PenguinEino/opensusi-tr10-sram512/klayout/dense_sram/array_and_fit.png

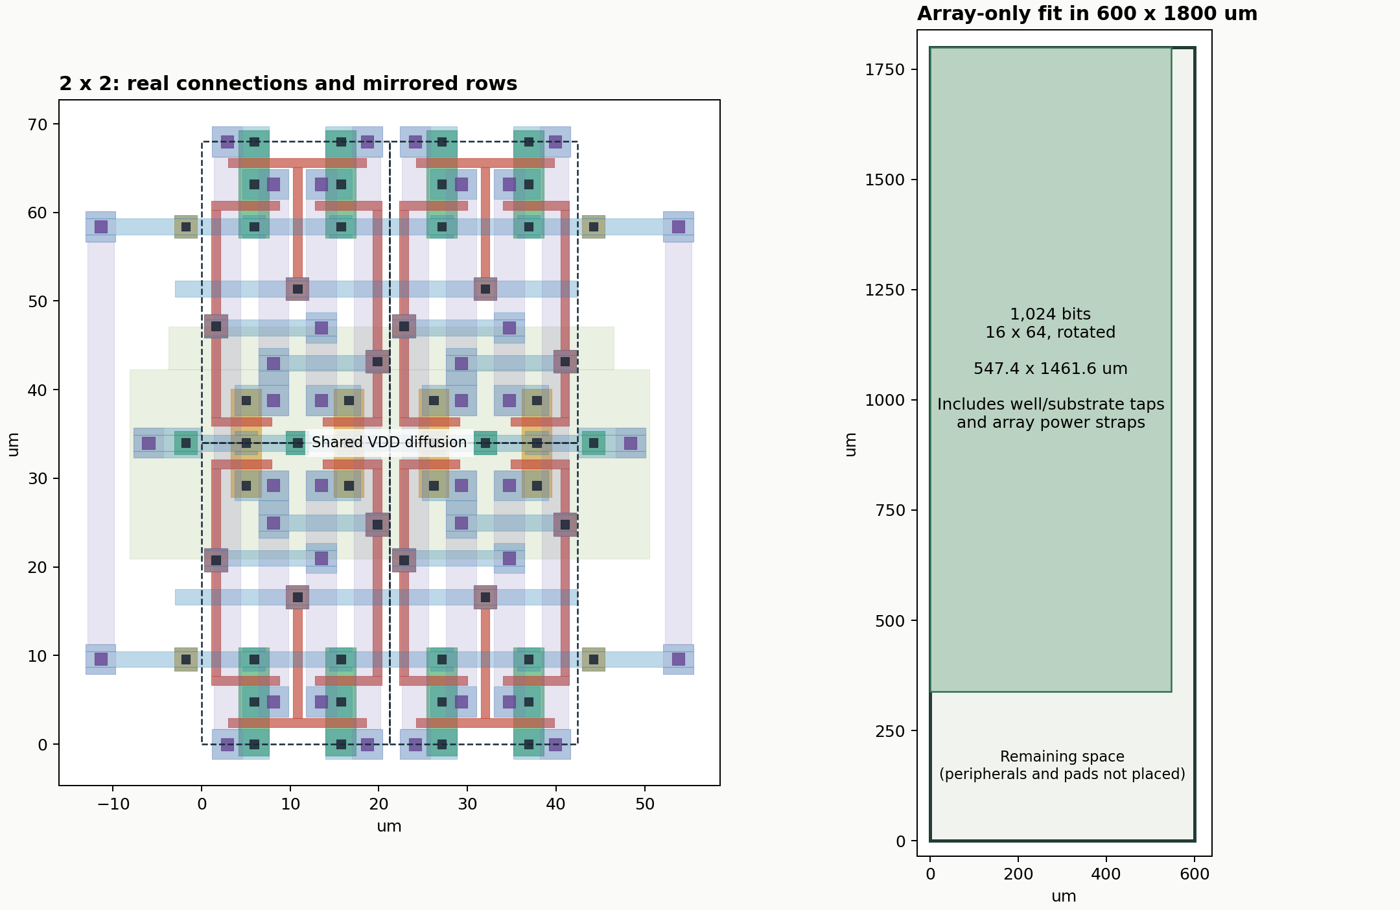
klayout/dense_sram/array_and_fit.png
