PenguinEino/opensusi-tr10-sram512/klayout/dense_sram/comparison.png

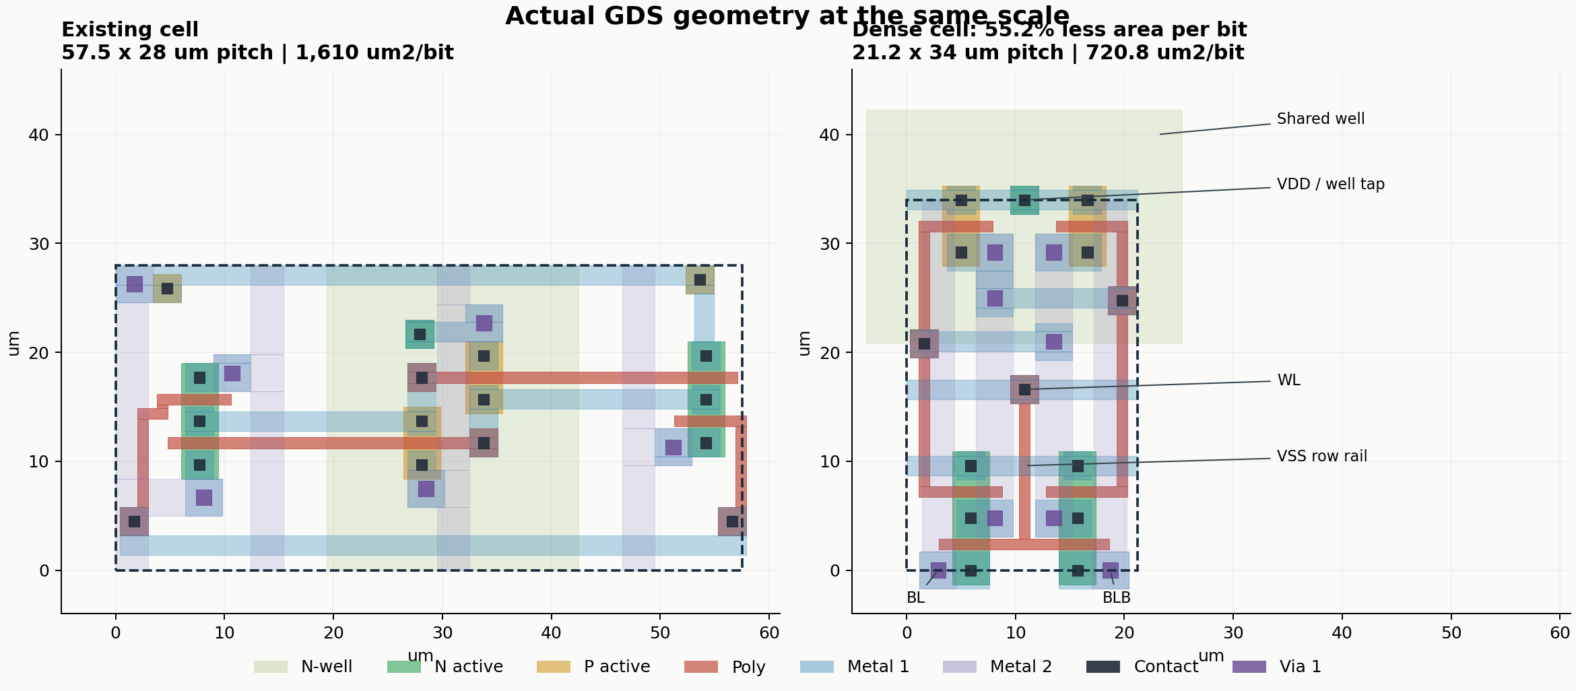
klayout/dense_sram/comparison.png
