PenguinEino/opensusi-tr10-sram512/klayout/sram_compact/capacity.png

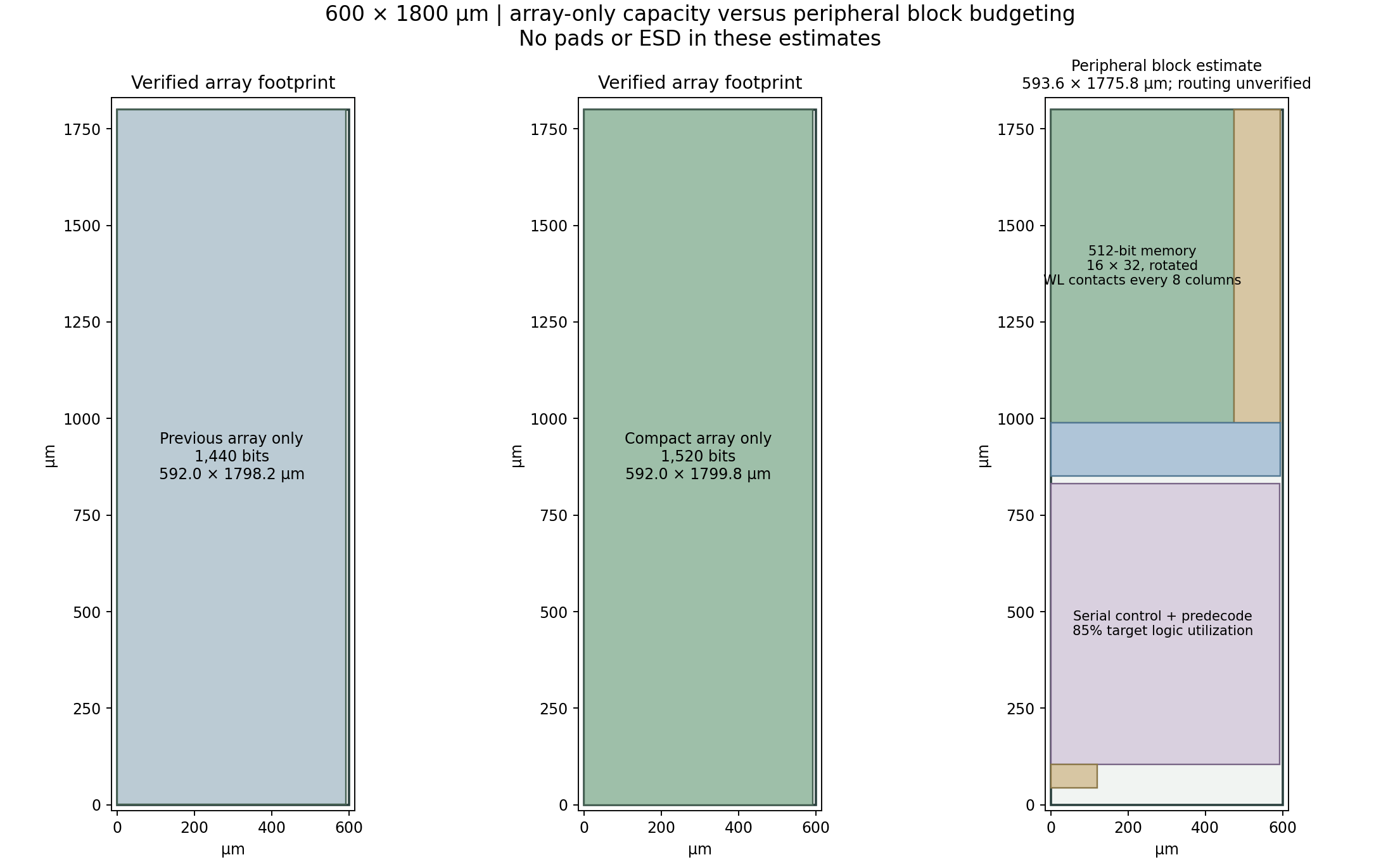
klayout/sram_compact/capacity.png
