PenguinEino/opensusi-tr10-sram512/klayout/sram_compact/cell_comparison.png

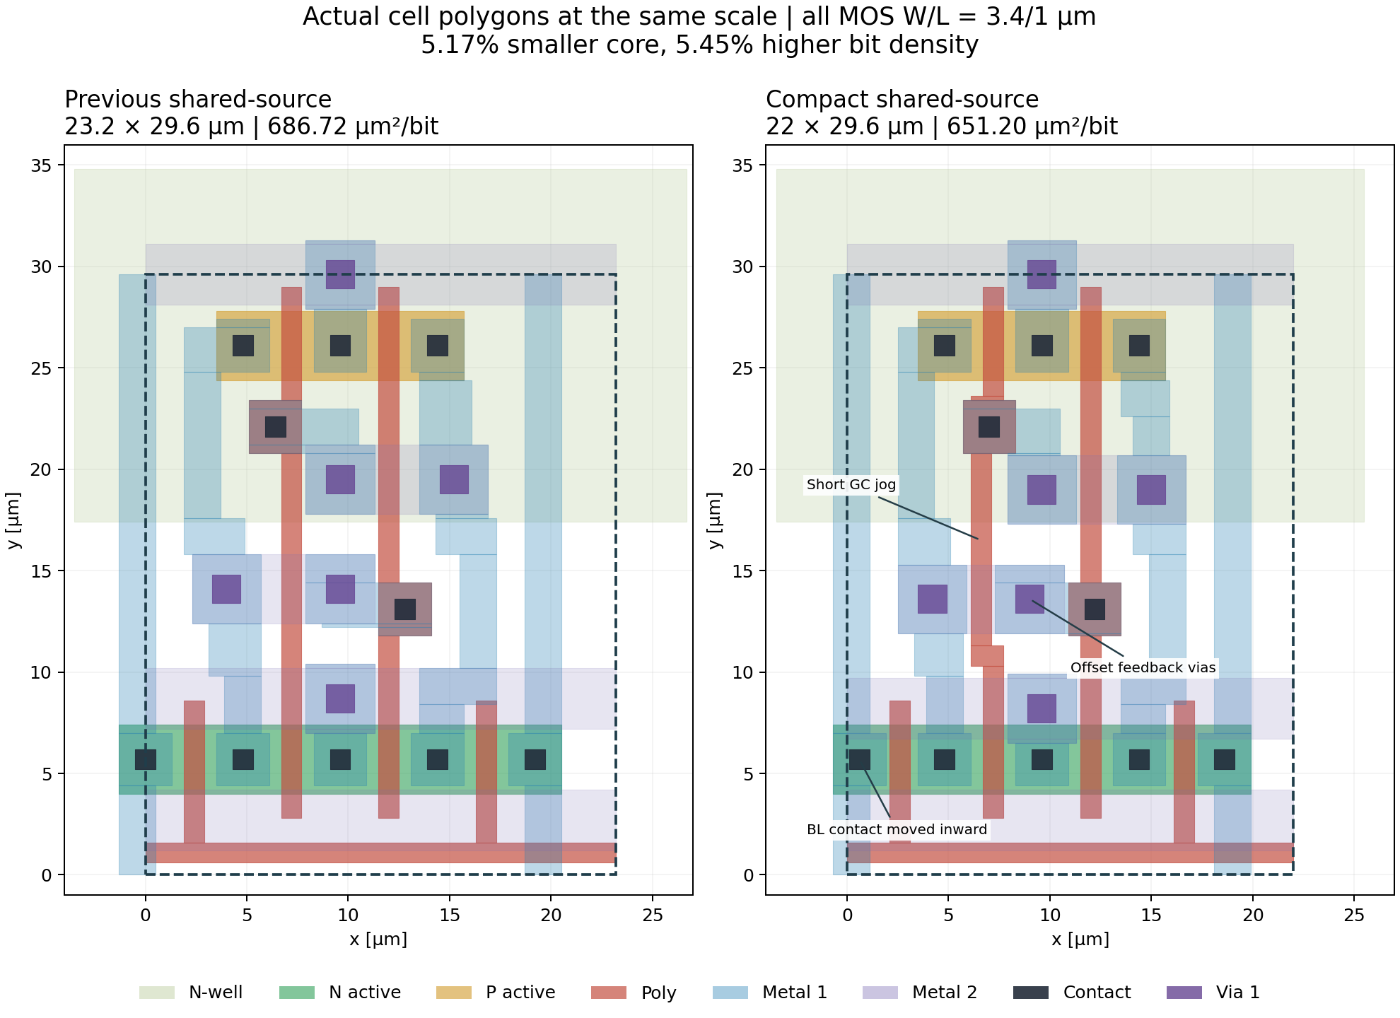
klayout/sram_compact/cell_comparison.png
