PenguinEino/opensusi-tr10-sram512/klayout/sram_macro_study/floorplans.png

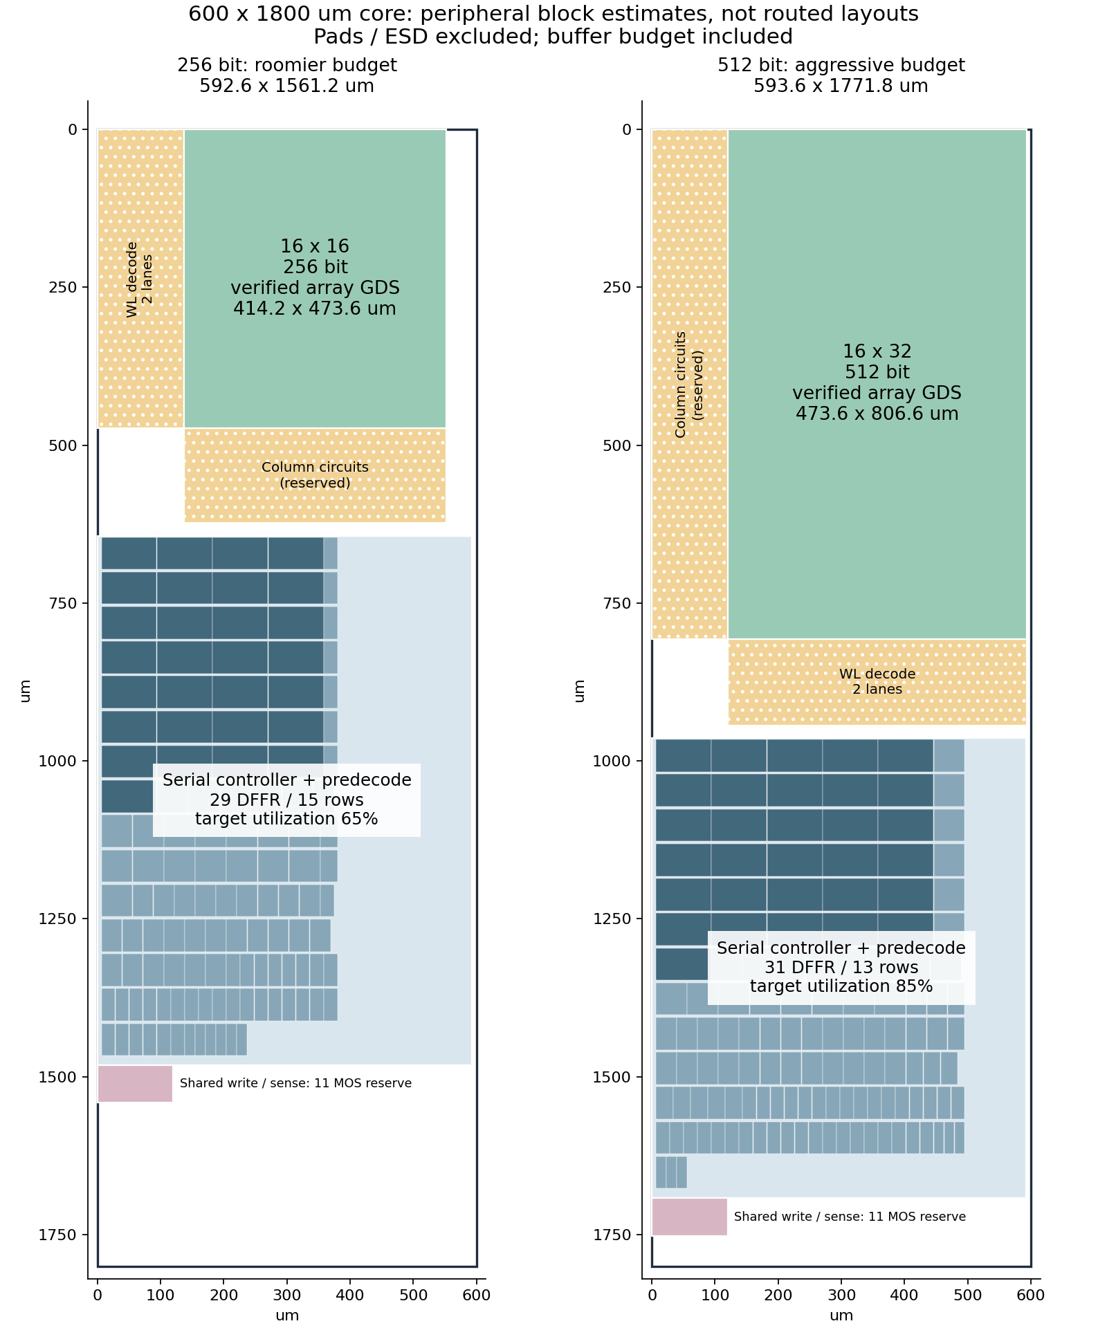
klayout/sram_macro_study/floorplans.png
