PenguinEino/opensusi-tr10-sram512/klayout/sram_macro_study/pitch.png

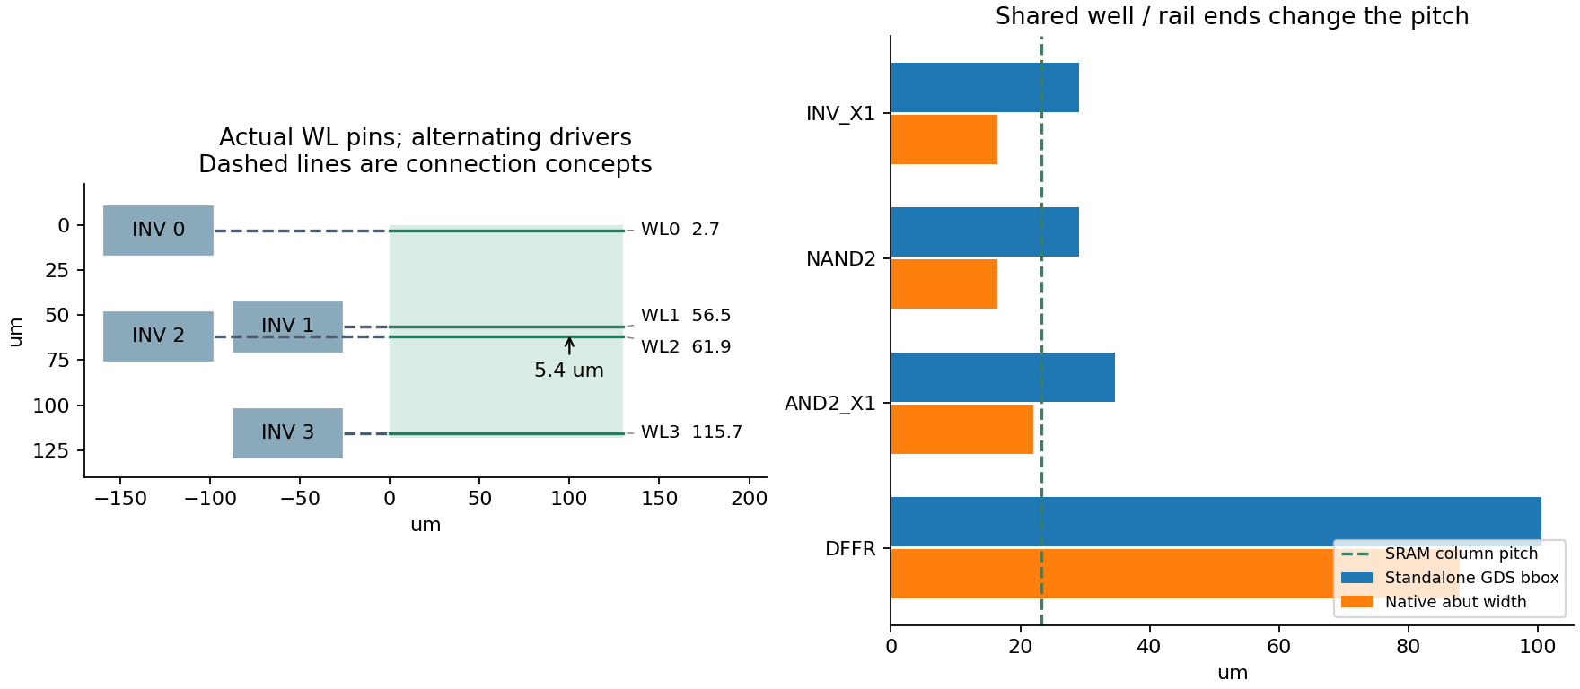
klayout/sram_macro_study/pitch.png
