PenguinEino/opensusi-tr10-sram512/klayout/sram_macro_study/strap_tradeoff.png

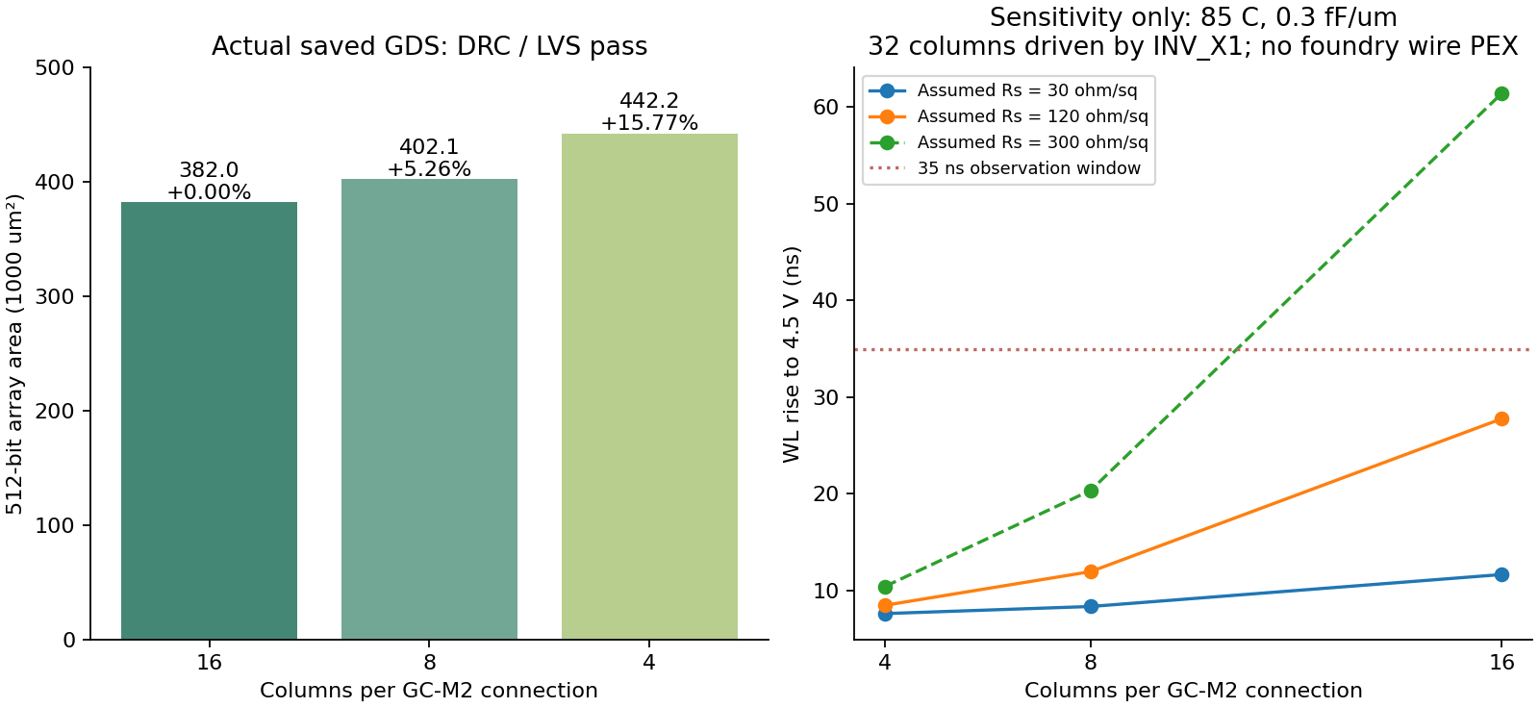
klayout/sram_macro_study/strap_tradeoff.png
