PenguinEino/opensusi-tr10-sram512/klayout/sram_pcell/scan_comparison.png

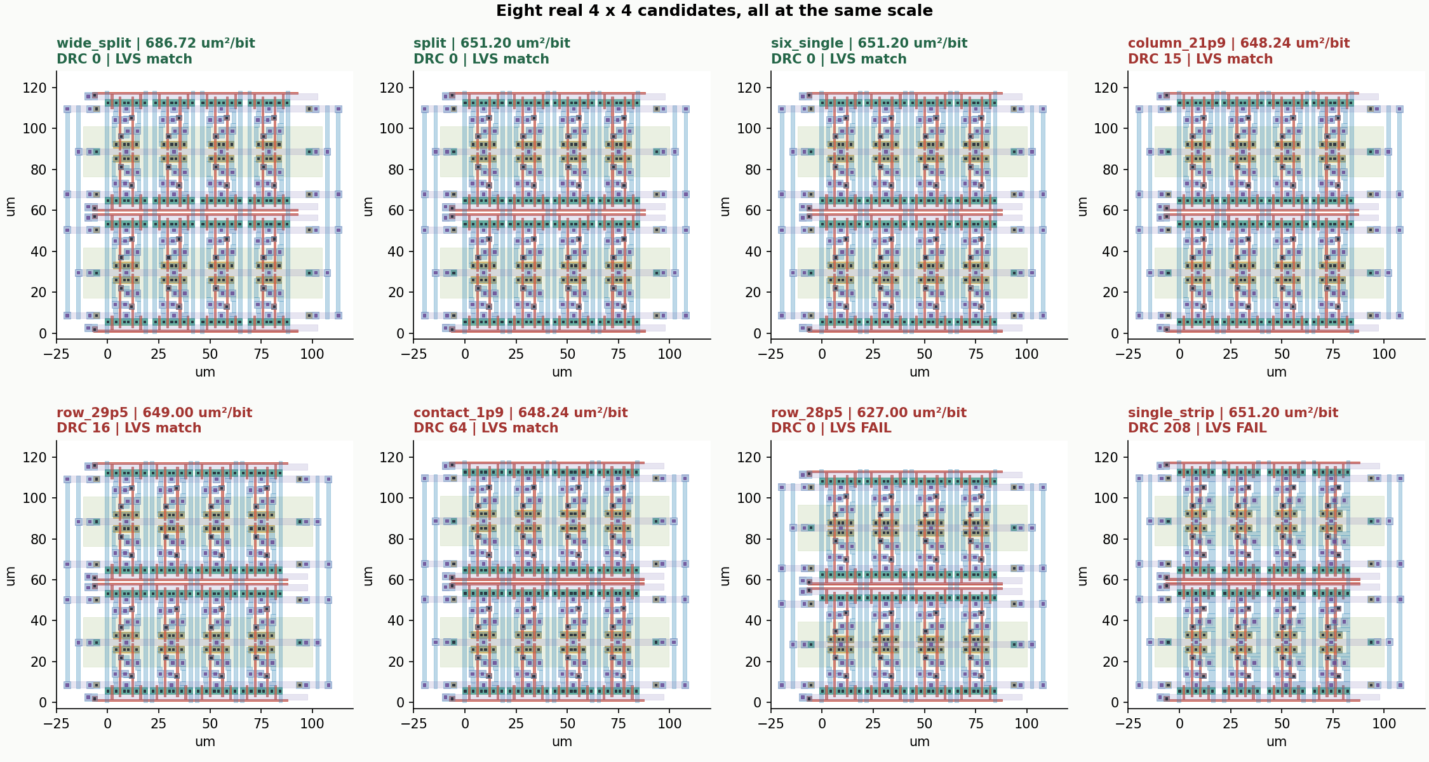
klayout/sram_pcell/scan_comparison.png
