PenguinEino/opensusi-tr10-sram512/klayout/sram_pcell/shared_capacity.png

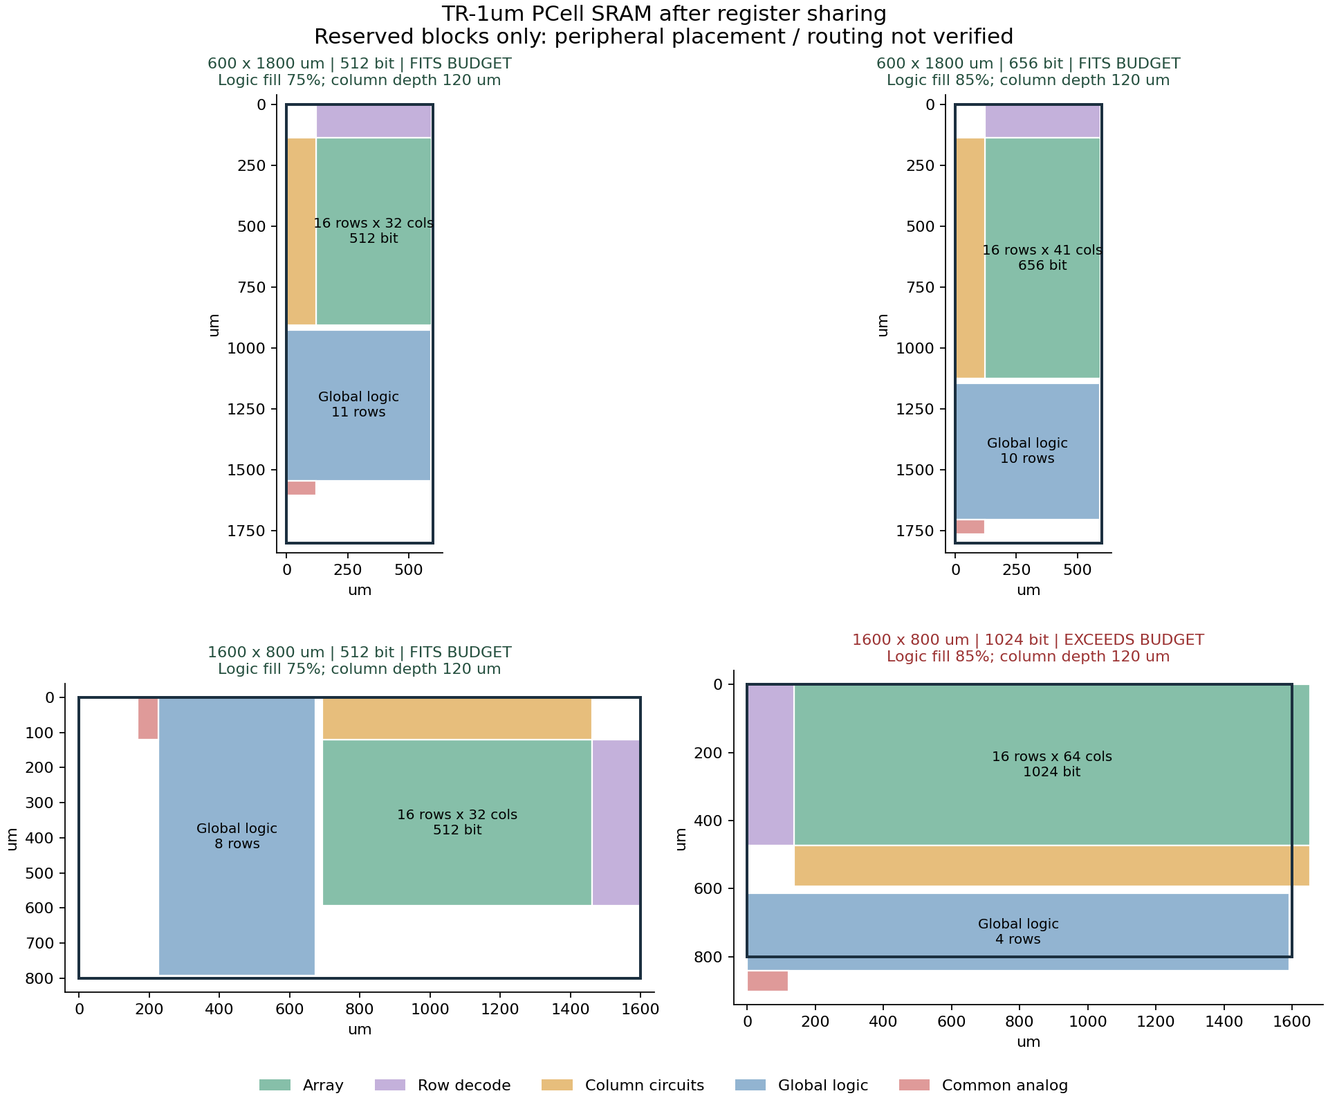
klayout/sram_pcell/shared_capacity.png
