PenguinEino/opensusi-tr10-sram512/klayout/sram_research/array_comparison.png

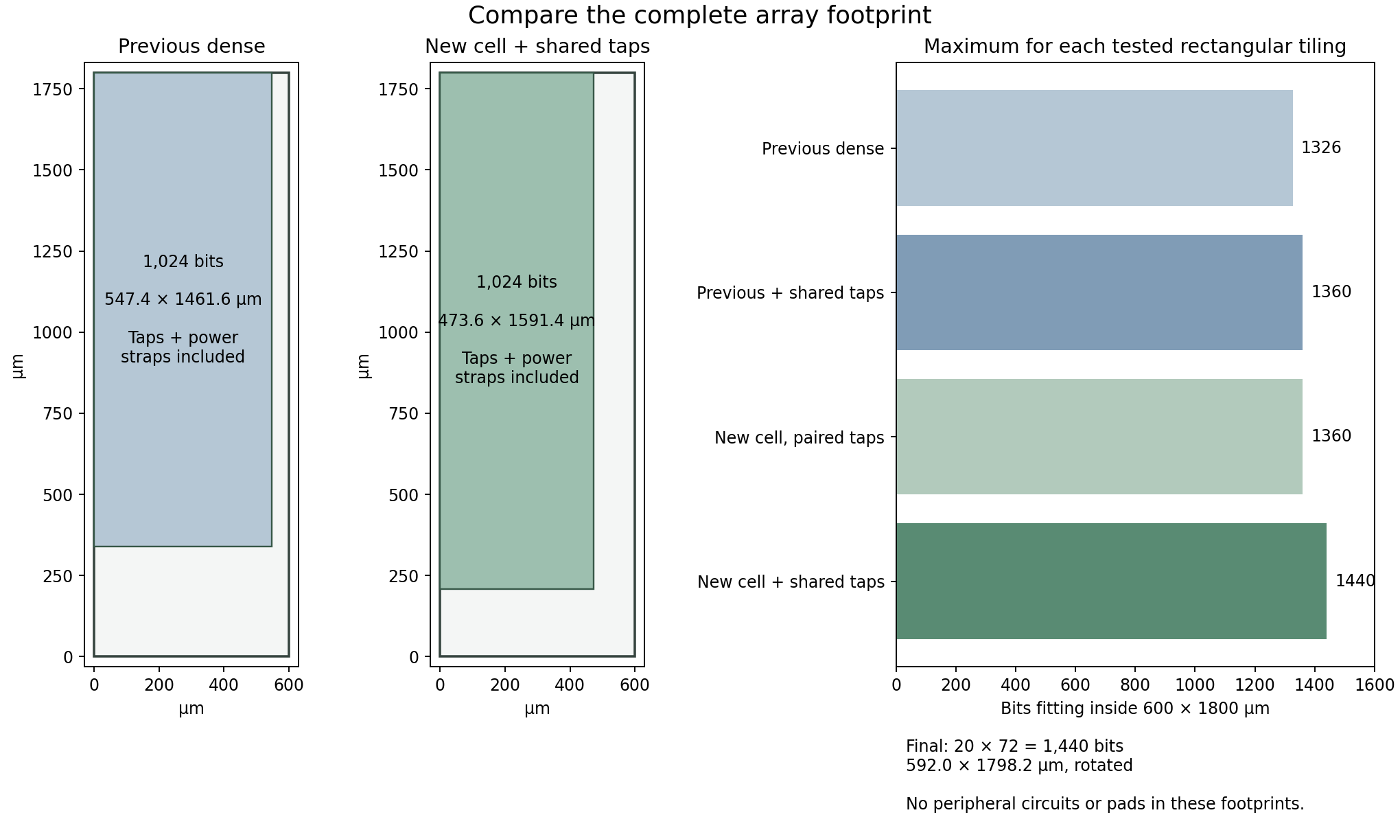
klayout/sram_research/array_comparison.png
