PenguinEino/opensusi-tr10-sram512/klayout/sram_research/array_detail.png

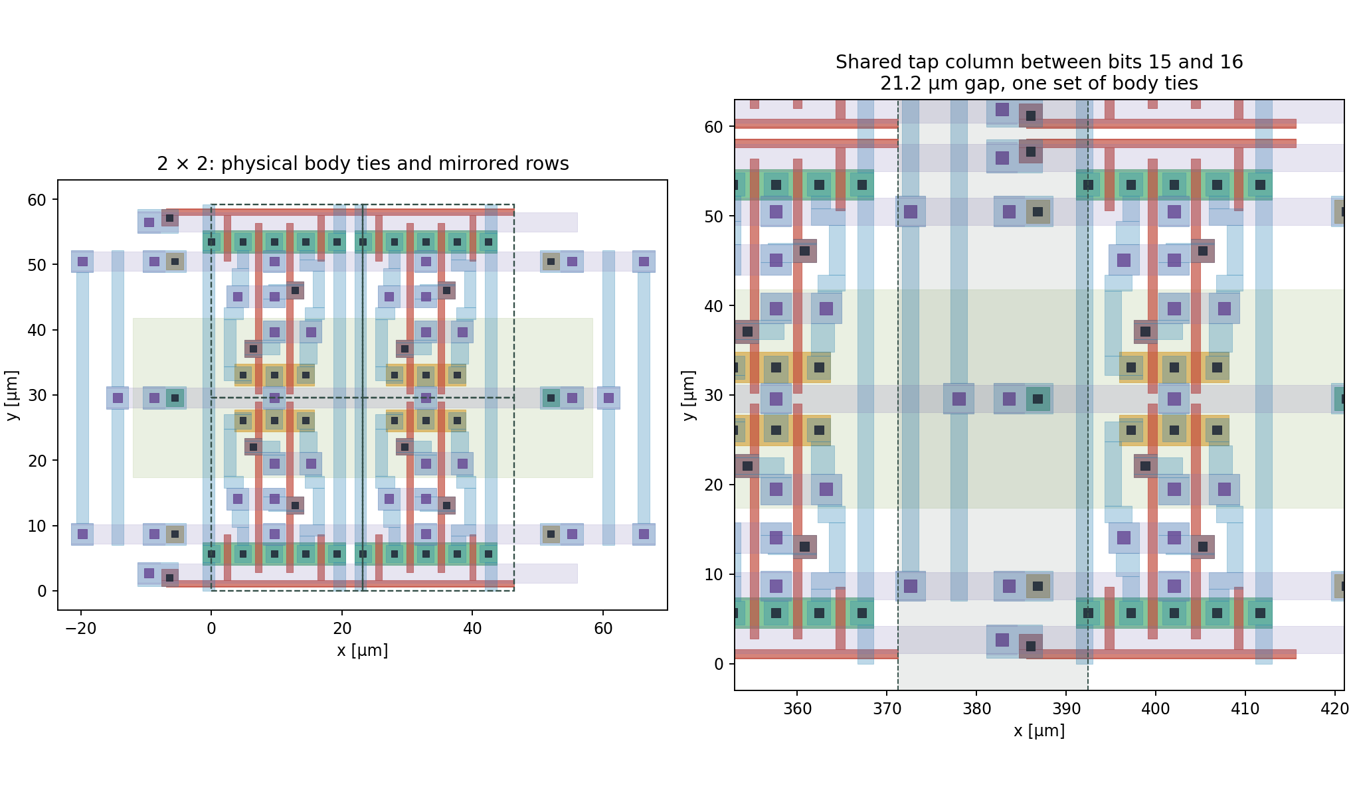
klayout/sram_research/array_detail.png
