PenguinEino/opensusi-tr10-sram512/klayout/sram_research/stability.png

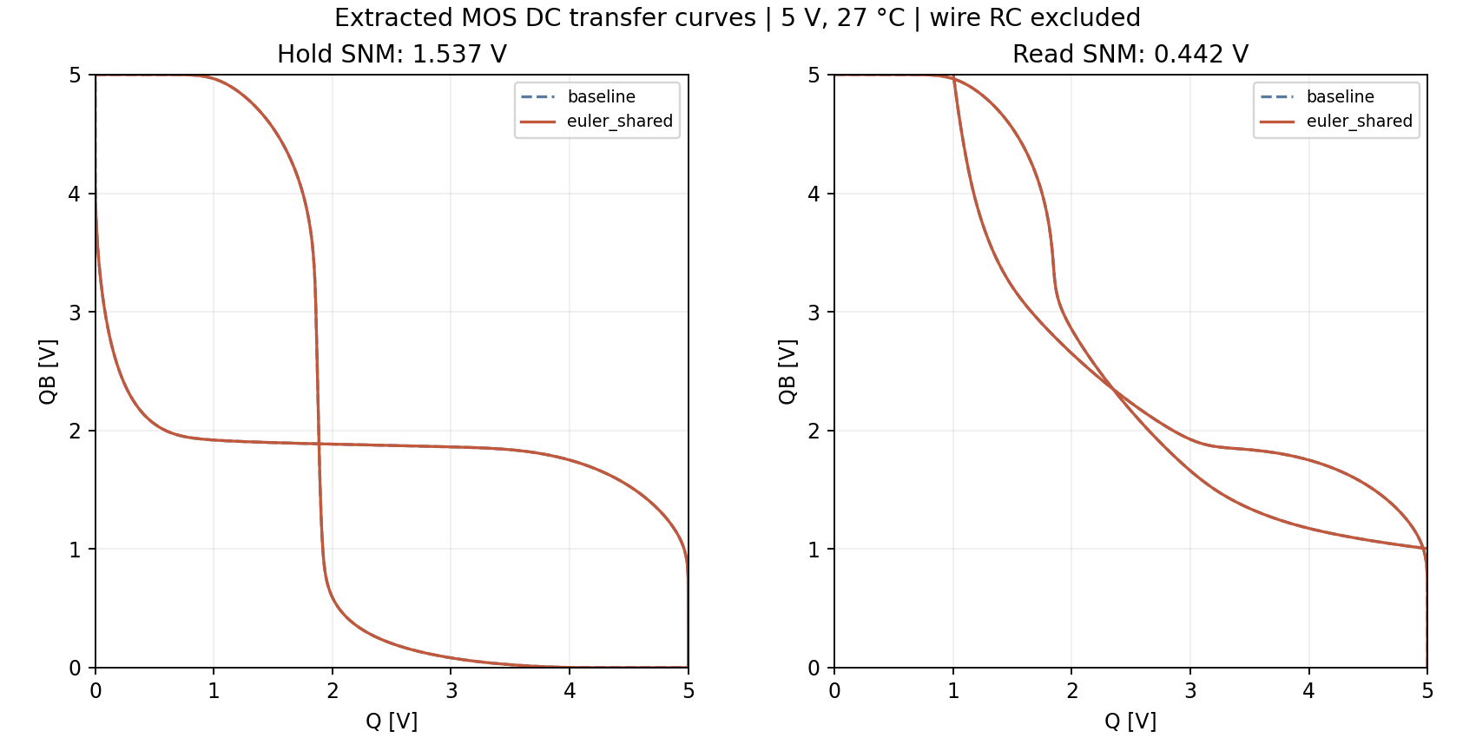
klayout/sram_research/stability.png
