PenguinEino/opensusi-tr10-sram512/klayout/sram_t4/array_comparison.png

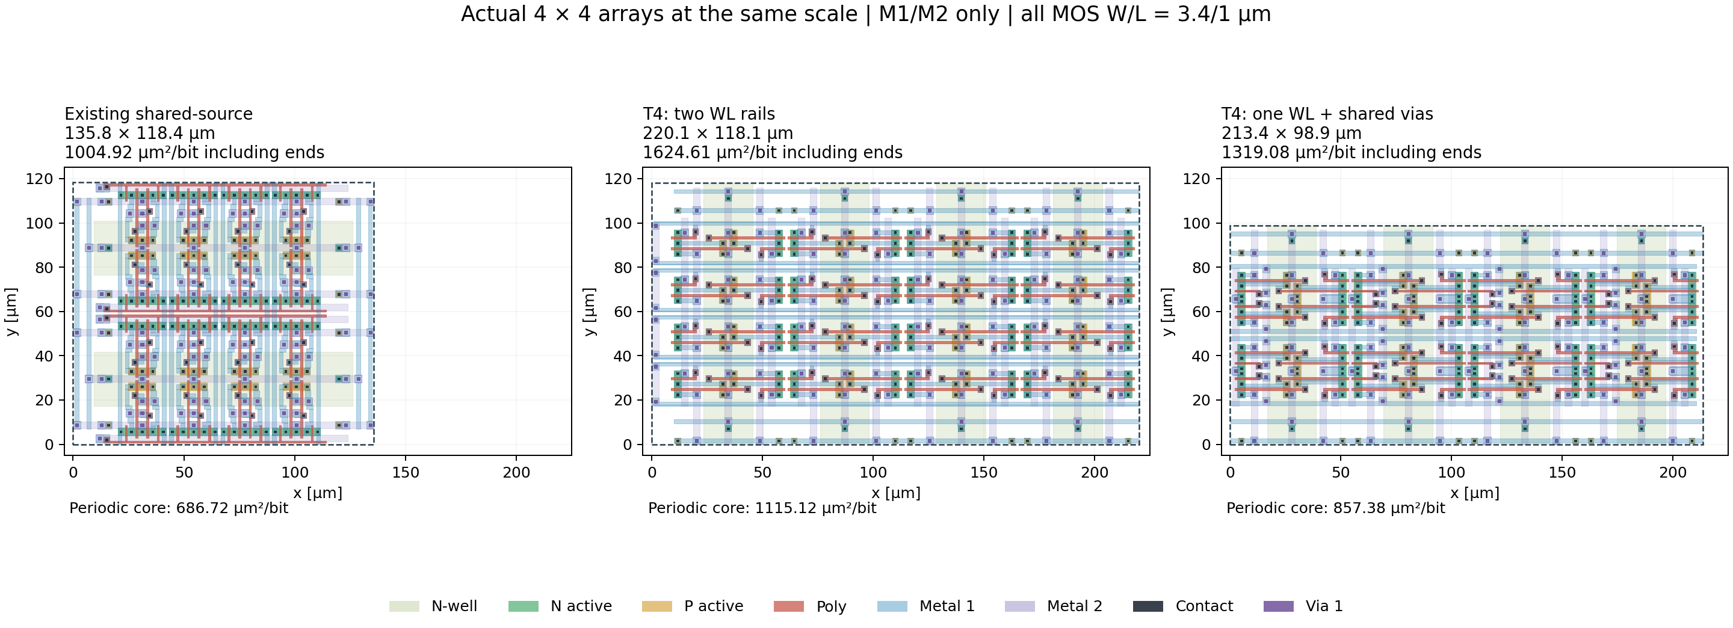
klayout/sram_t4/array_comparison.png
