PenguinEino/opensusi-tr10-sram512/klayout/sram_t4/singlewl_detail.png

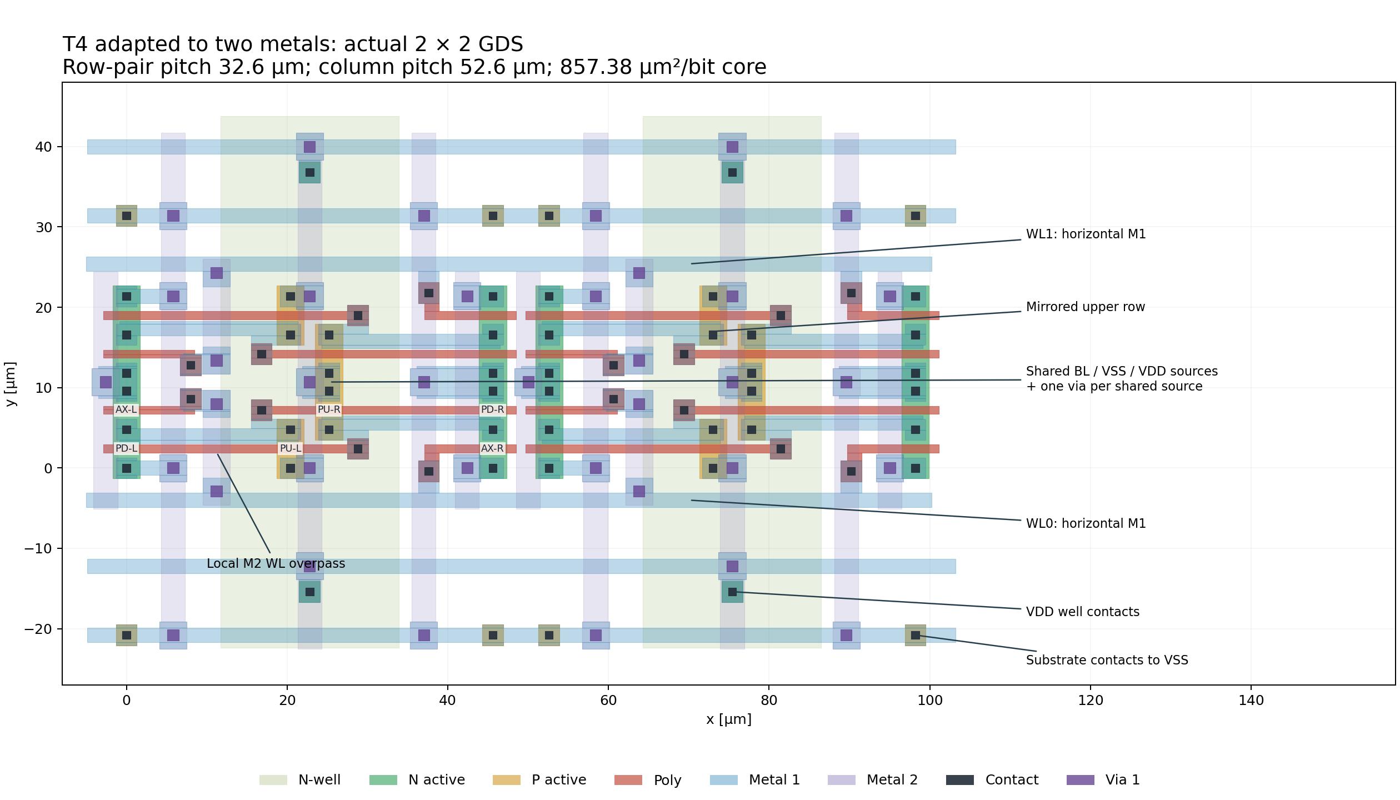
klayout/sram_t4/singlewl_detail.png
