PenguinEino/opensusi-tr10-sram512/learning/simulation/cell_sense_capacitance.png

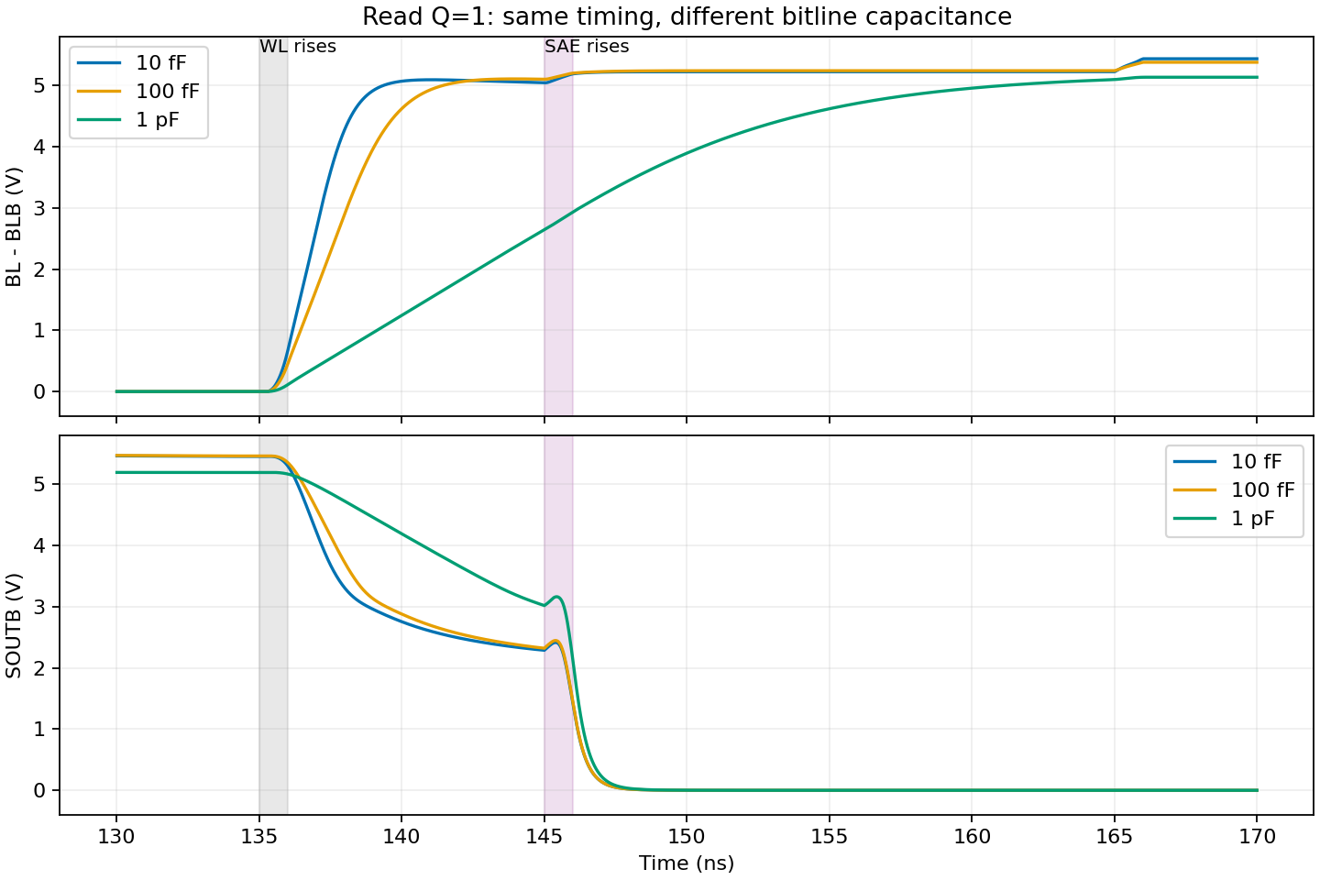
learning/simulation/cell_sense_capacitance.png
