PenguinEino/opensusi-tr10-sram512/reviews/sram512_review_2026-09-13.png

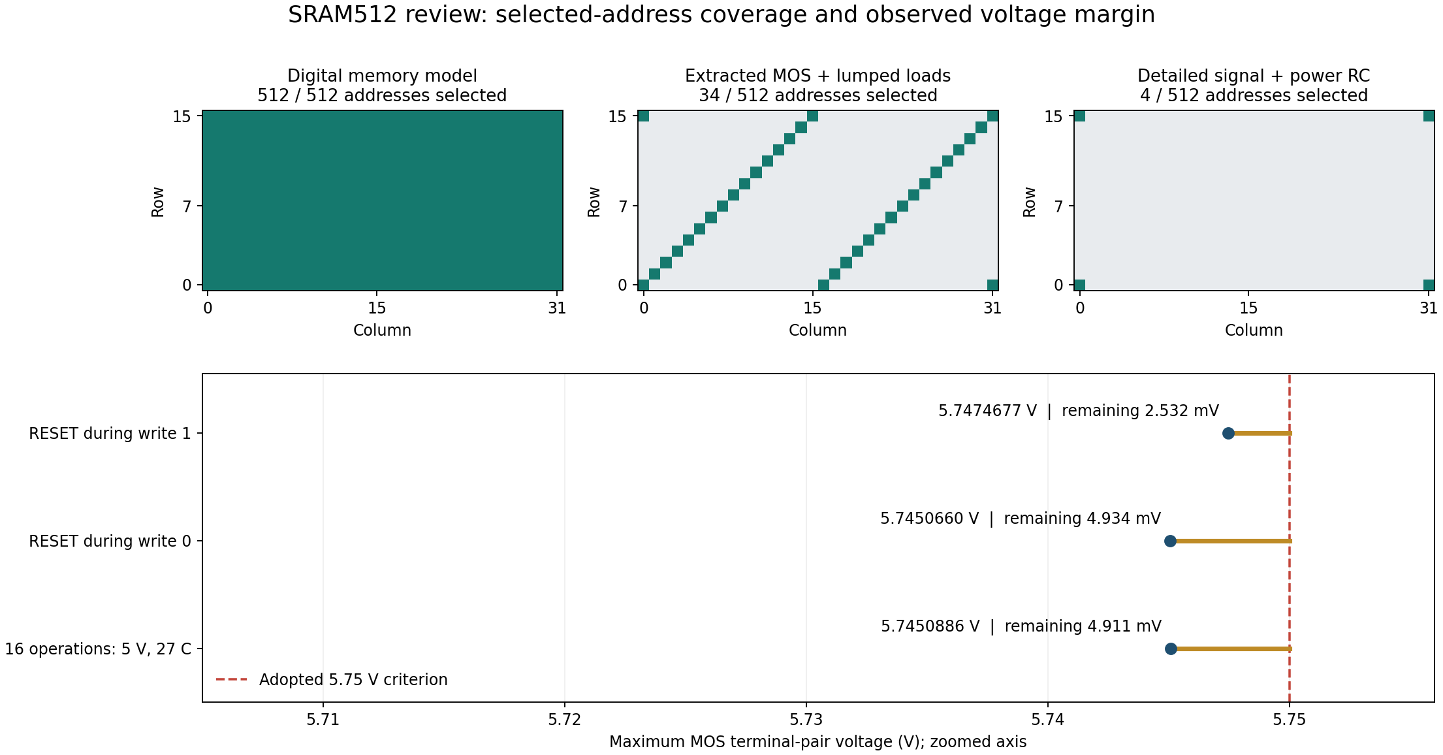
reviews/sram512_review_2026-09-13.png
