PenguinEino/opensusi-tr10-sram512/reviews/sram_review_2026-09-11.png

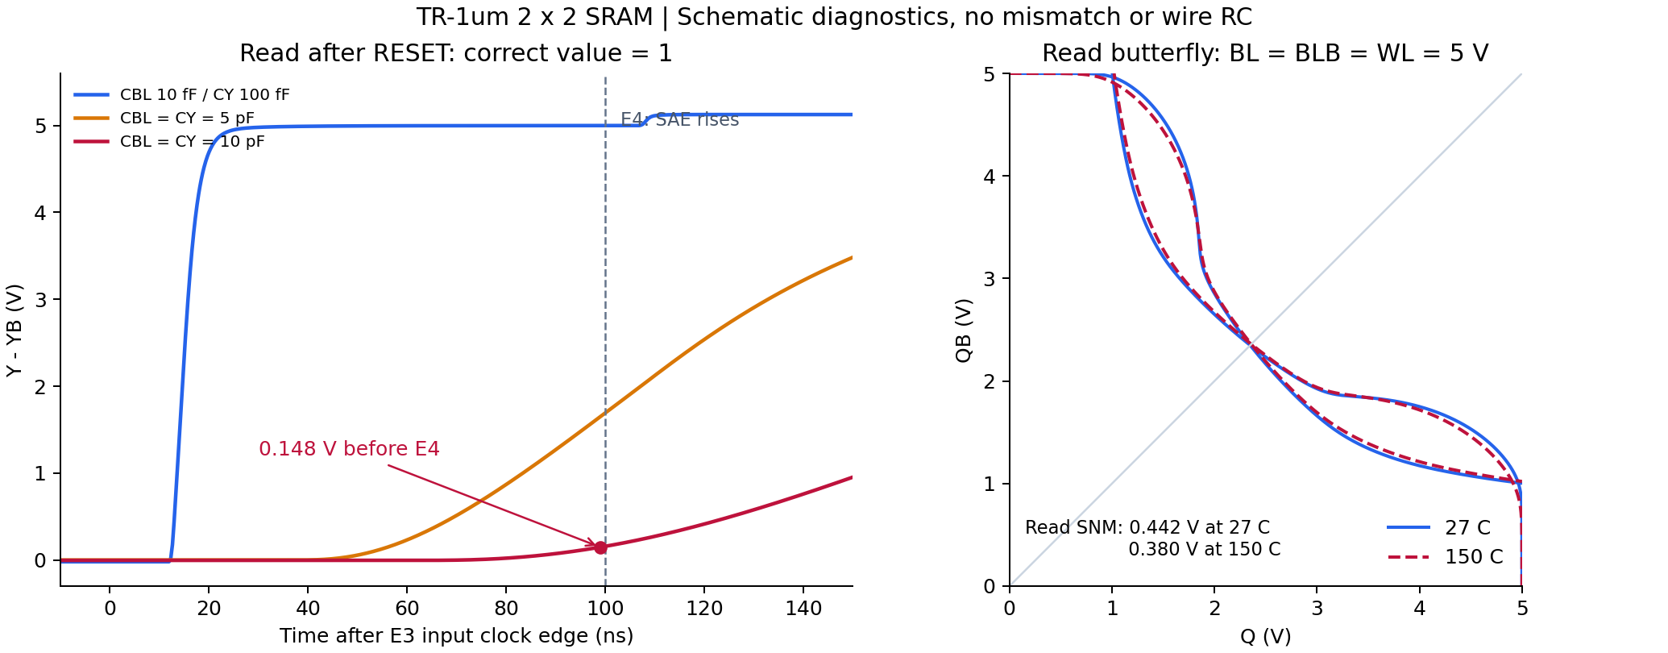
reviews/sram_review_2026-09-11.png
