PenguinEino/opensusi-tr10-sram512/reviews/sram_shared_frame_retest_2026-09-12.png

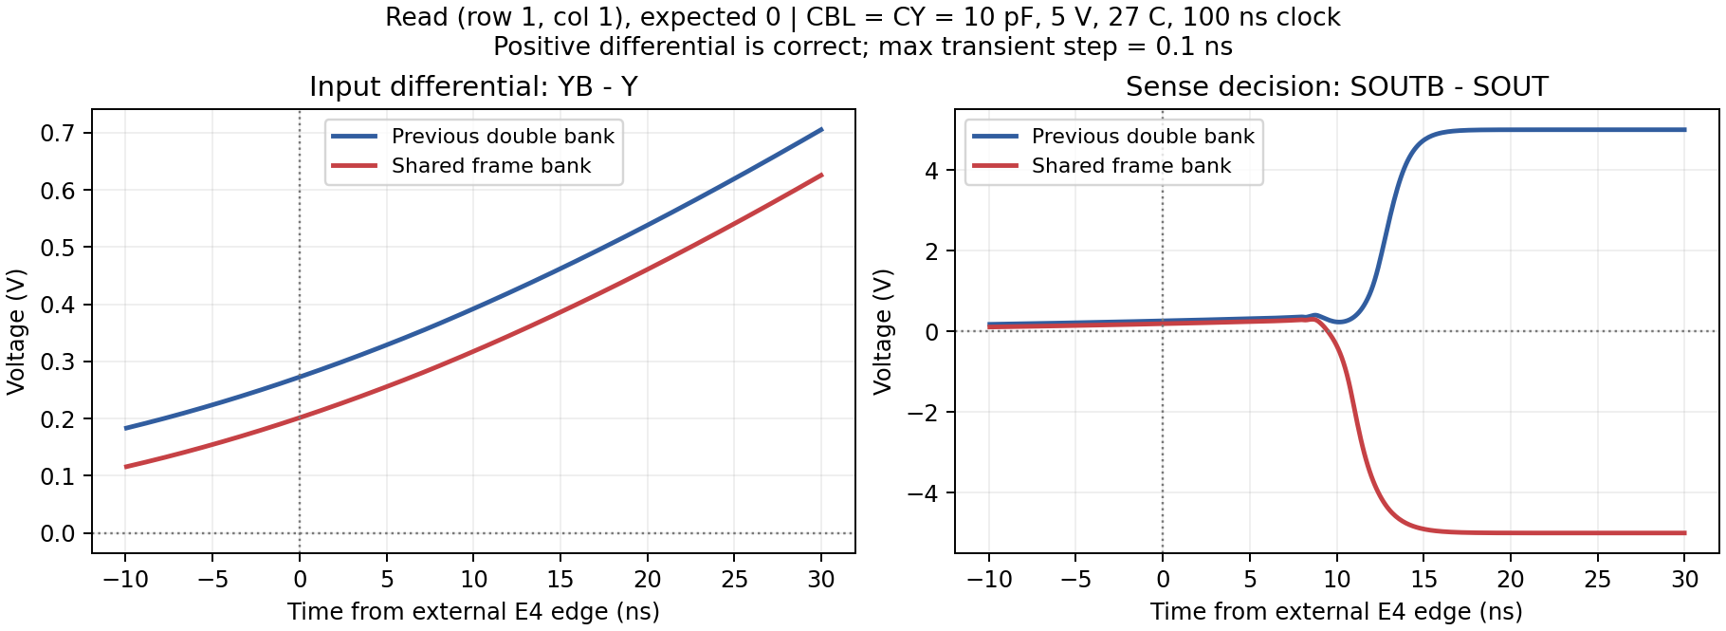
reviews/sram_shared_frame_retest_2026-09-12.png
