PenguinEino/opensusi-tr10-sram512/sram512/reports/decoderfix_route_waveforms.png

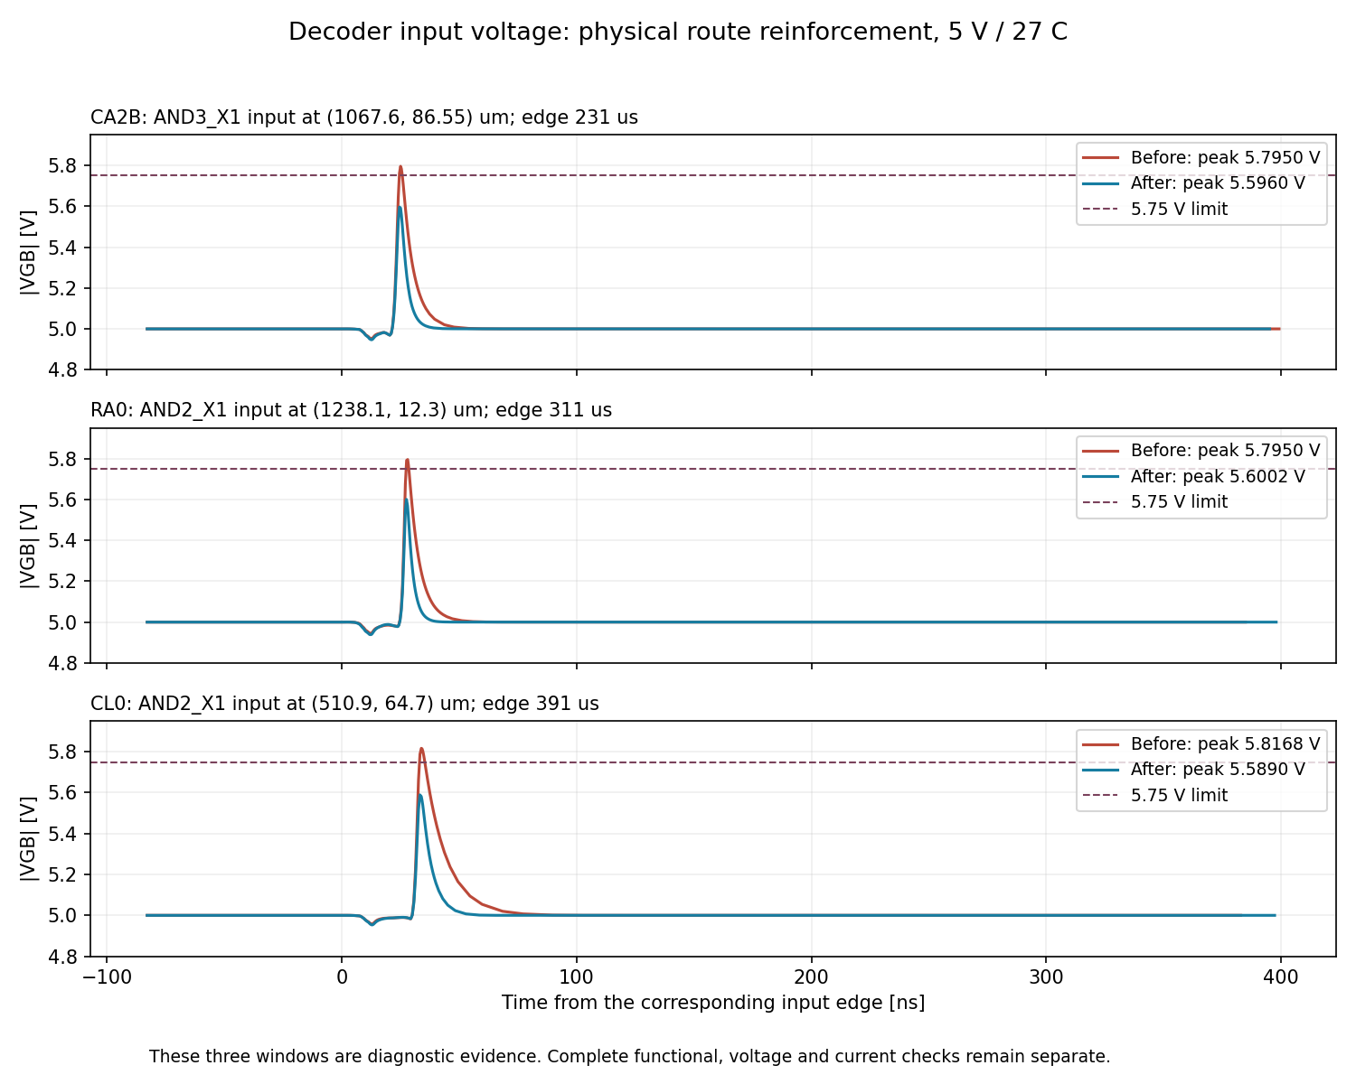
sram512/reports/decoderfix_route_waveforms.png
