PenguinEino/opensusi-tr10-sram512/sram512/reports/decoderfix_startup.png

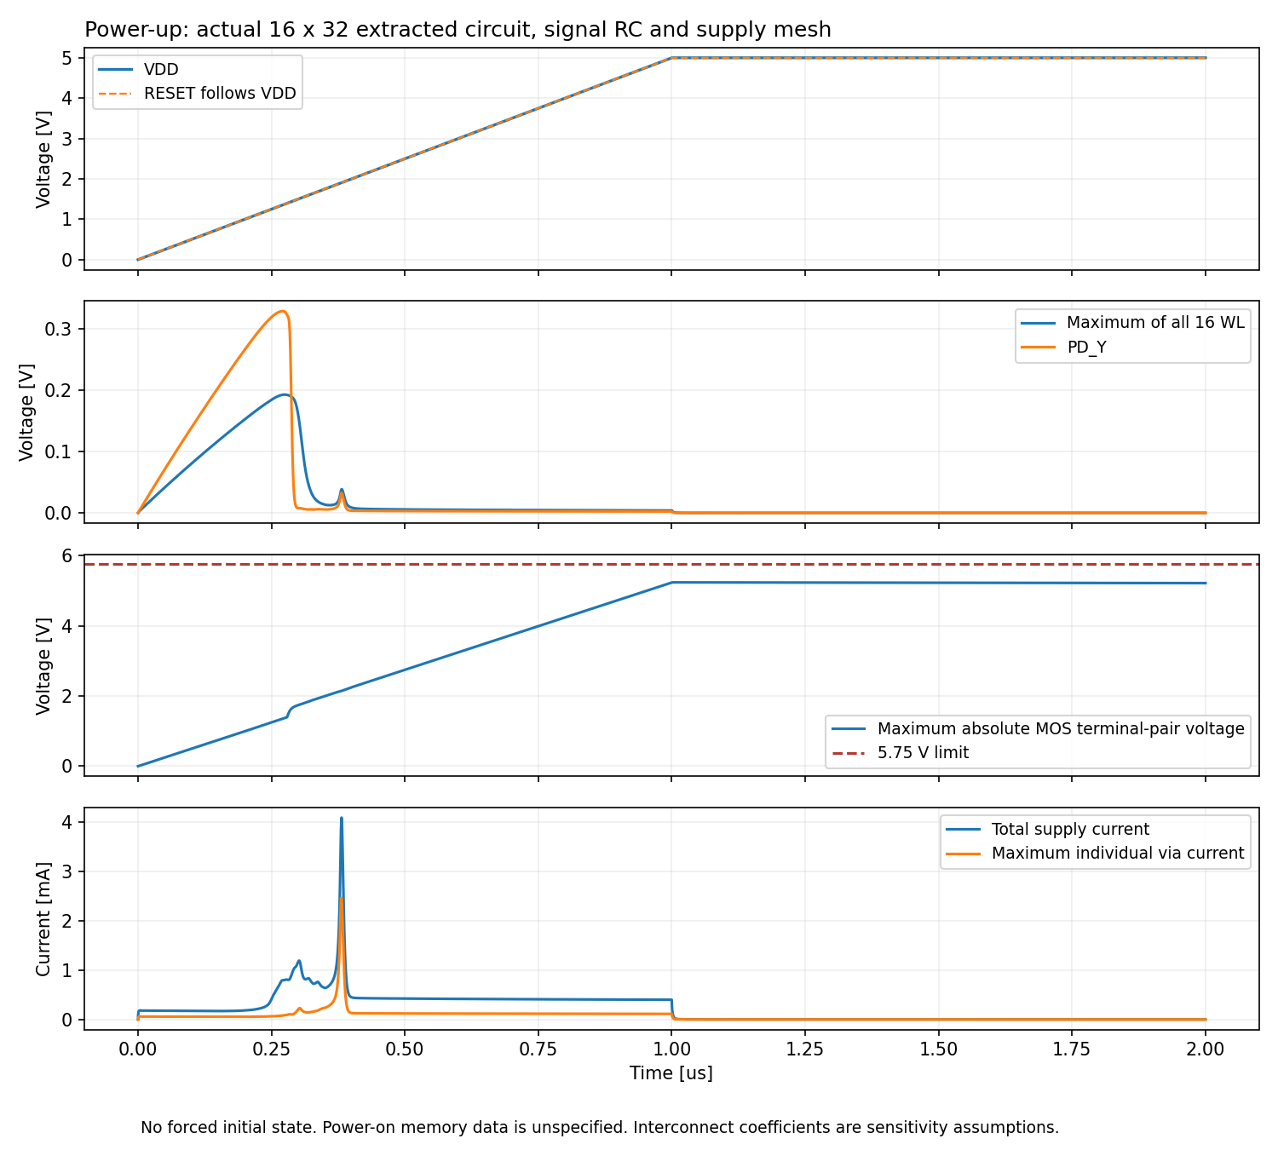
sram512/reports/decoderfix_startup.png
