PenguinEino/opensusi-tr10-sram512/sram512/reports/signalfix_route_waveforms.png

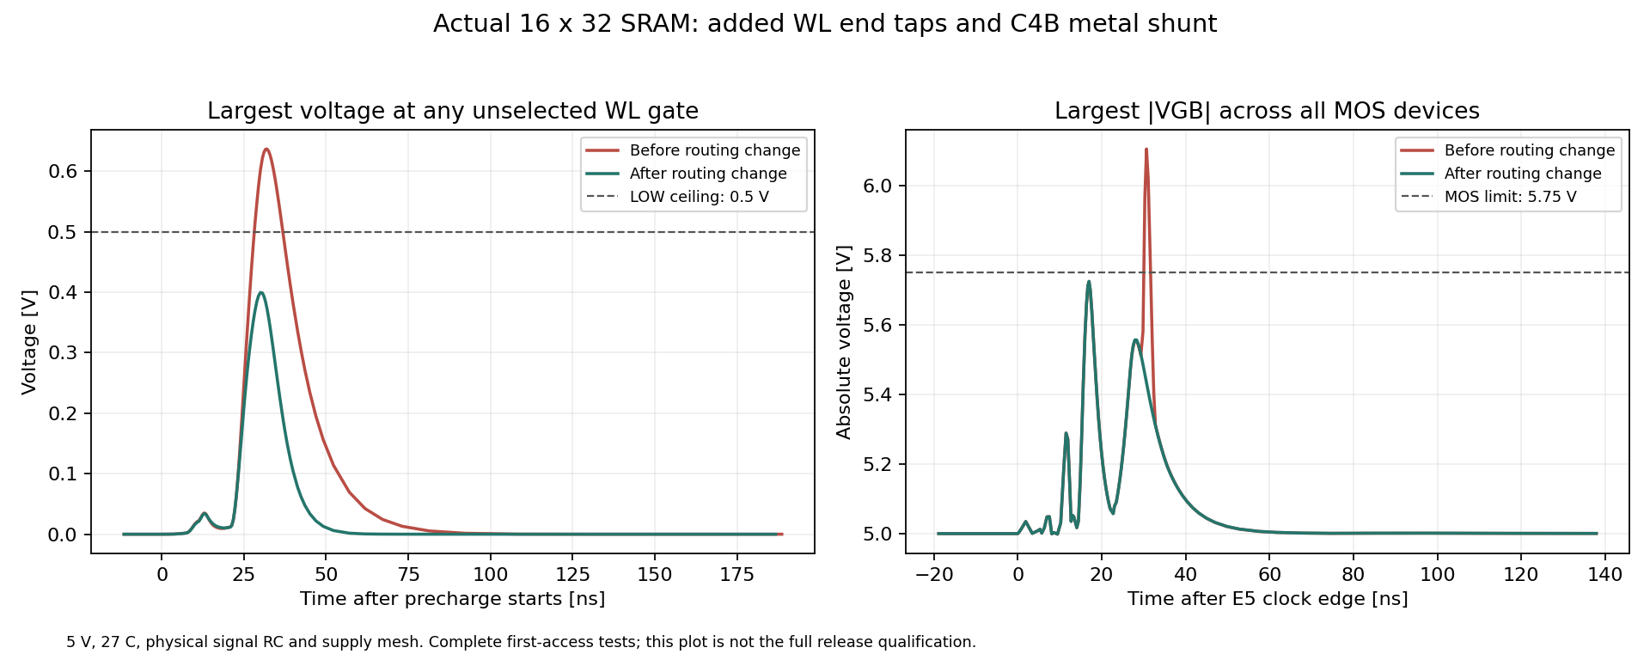
sram512/reports/signalfix_route_waveforms.png
