PenguinEino/opensusi-tr10-sram512/sram512/reports/write_driver_comparison.png

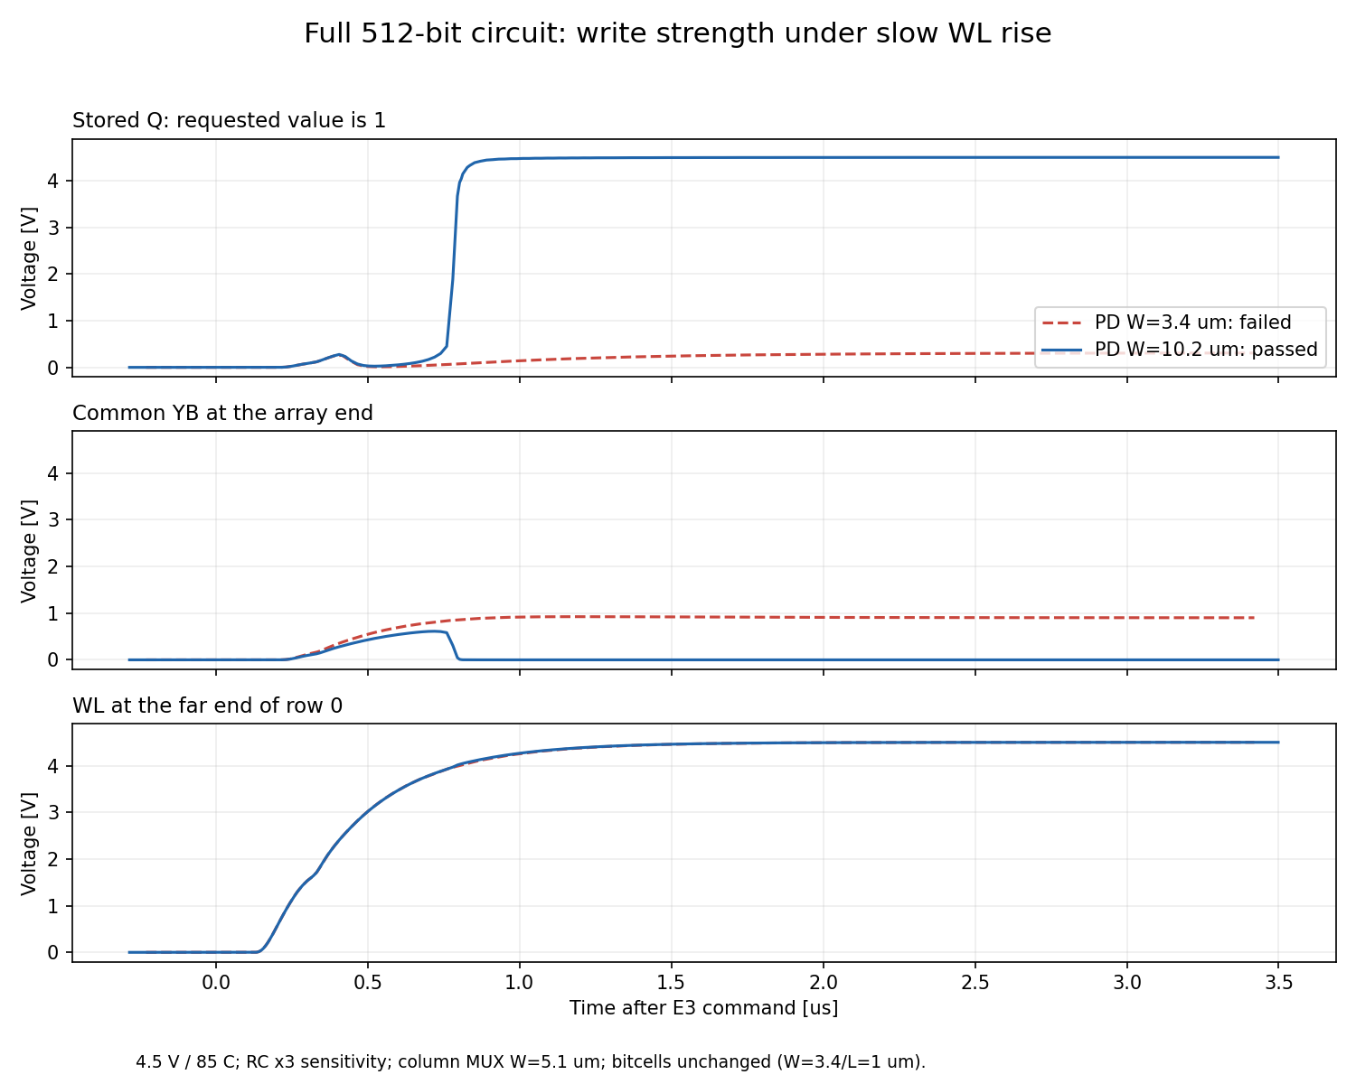
sram512/reports/write_driver_comparison.png
