PenguinEino/opensusi-tr10-sram512/submission/sram512_pins.png

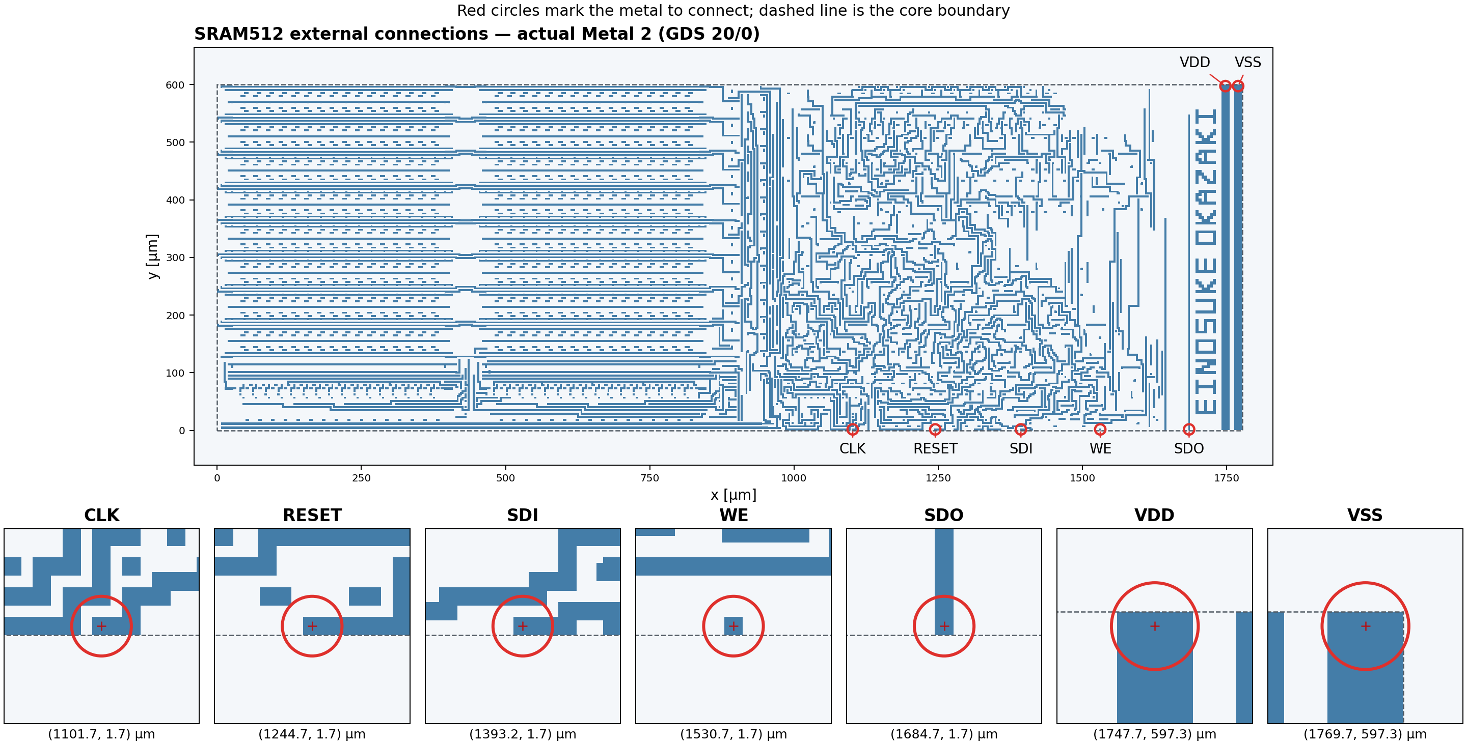
submission/sram512_pins.png
