PenguinEino/opensusi-tr10-sram512/sram512/layout/reference.spice

** sch_path: /home/ishi-kai/sram/sram512_macro.sch
.subckt sram512_macro CLK RESET SDI WE SDO VDD VSS
*.PININFO CLK:I RESET:I SDI:I WE:I SDO:O VDD:B VSS:B
xcore CLK RESET SDI WE SDO VDD VSS sram512
.ends

* expanding   symbol:  sram512.sym # of pins=7
** sym_path: /home/ishi-kai/sram/sram512.sym
** sch_path: /home/ishi-kai/sram/sram512.sch
.subckt sram512 CLK RESET SDI WE SDO VDD VSS
*.PININFO CLK:I RESET:I SDI:I WE:I SDO:O VDD:B VSS:B
xarray WL0 WL1 WL2 WL3 WL4 WL5 WL6 WL7 WL8 WL9 WL10 WL11 WL12 WL13 WL14 WL15 BL0 BLB0 BL1 BLB1 BL2 BLB2 BL3 BLB3 BL4 BLB4 BL5 BLB5
+ BL6 BLB6 BL7 BLB7 BL8 BLB8 BL9 BLB9 BL10 BLB10 BL11 BLB11 BL12 BLB12 BL13 BLB13 BL14 BLB14 BL15 BLB15 BL16 BLB16 BL17 BLB17 BL18
+ BLB18 BL19 BLB19 BL20 BLB20 BL21 BLB21 BL22 BLB22 BL23 BLB23 BL24 BLB24 BL25 BLB25 BL26 BLB26 BL27 BLB27 BL28 BLB28 BL29 BLB29 BL30
+ BLB30 BL31 BLB31 VDD VSS sram512_array
xrow RA0 RA1 RA2 RA3 WL_EN WL0 WL1 WL2 WL3 WL4 WL5 WL6 WL7 WL8 WL9 WL10 WL11 WL12 WL13 WL14 WL15 VDD VSS sram512_row_decoder
xcol0 BL0 BLB0 Y YB COL0 PREB VDD VSS sram512_column
xcol1 BL1 BLB1 Y YB COL1 PREB VDD VSS sram512_column
xcol2 BL2 BLB2 Y YB COL2 PREB VDD VSS sram512_column
xcol3 BL3 BLB3 Y YB COL3 PREB VDD VSS sram512_column
xcol4 BL4 BLB4 Y YB COL4 PREB VDD VSS sram512_column
xcol5 BL5 BLB5 Y YB COL5 PREB VDD VSS sram512_column
xcol6 BL6 BLB6 Y YB COL6 PREB VDD VSS sram512_column
xcol7 BL7 BLB7 Y YB COL7 PREB VDD VSS sram512_column
xcol8 BL8 BLB8 Y YB COL8 PREB VDD VSS sram512_column
xcol9 BL9 BLB9 Y YB COL9 PREB VDD VSS sram512_column
xcol10 BL10 BLB10 Y YB COL10 PREB VDD VSS sram512_column
xcol11 BL11 BLB11 Y YB COL11 PREB VDD VSS sram512_column
xcol12 BL12 BLB12 Y YB COL12 PREB VDD VSS sram512_column
xcol13 BL13 BLB13 Y YB COL13 PREB VDD VSS sram512_column
xcol14 BL14 BLB14 Y YB COL14 PREB VDD VSS sram512_column
xcol15 BL15 BLB15 Y YB COL15 PREB VDD VSS sram512_column
xcol16 BL16 BLB16 Y YB COL16 PREB VDD VSS sram512_column
xcol17 BL17 BLB17 Y YB COL17 PREB VDD VSS sram512_column
xcol18 BL18 BLB18 Y YB COL18 PREB VDD VSS sram512_column
xcol19 BL19 BLB19 Y YB COL19 PREB VDD VSS sram512_column
xcol20 BL20 BLB20 Y YB COL20 PREB VDD VSS sram512_column
xcol21 BL21 BLB21 Y YB COL21 PREB VDD VSS sram512_column
xcol22 BL22 BLB22 Y YB COL22 PREB VDD VSS sram512_column
xcol23 BL23 BLB23 Y YB COL23 PREB VDD VSS sram512_column
xcol24 BL24 BLB24 Y YB COL24 PREB VDD VSS sram512_column
xcol25 BL25 BLB25 Y YB COL25 PREB VDD VSS sram512_column
xcol26 BL26 BLB26 Y YB COL26 PREB VDD VSS sram512_column
xcol27 BL27 BLB27 Y YB COL27 PREB VDD VSS sram512_column
xcol28 BL28 BLB28 Y YB COL28 PREB VDD VSS sram512_column
xcol29 BL29 BLB29 Y YB COL29 PREB VDD VSS sram512_column
xcol30 BL30 BLB30 Y YB COL30 PREB VDD VSS sram512_column
xcol31 BL31 BLB31 Y YB COL31 PREB VDD VSS sram512_column
xcol_decode COL0 COL1 COL2 COL3 COL4 COL5 COL6 COL7 COL8 COL9 COL10 COL11 COL12 COL13 COL14 COL15 COL16 COL17 COL18 COL19 COL20
+ COL21 COL22 COL23 COL24 COL25 COL26 COL27 COL28 COL29 COL30 COL31 CA0 CA0B CA1 CA1B CA2 CA2B CA3 CA3B CA4 CA4B VDD VSS
+ sram512_col_decoder
xsense Y YB SAE SOUT SOUTB VDD VSS sense_amp_7t
Mxpc_Y Y PREB VDD VDD PMOS w=10.2u l=1u
Mxwrite_Y Y PD_Y VSS VSS NMOS w=10.2u l=1u
xwrite_data0 VDD PD_Y DINB WRITE_EN VSS AND2_X1
Mxpc_YB YB PREB VDD VDD PMOS w=10.2u l=1u
Mxwrite_YB YB PD_YB VSS VSS NMOS w=10.2u l=1u
xwrite_data1 VDD PD_YB DIN WRITE_EN VSS AND2_X1
xctrl CLK RESET SDI WE SOUT DIN DINB CA0 CA0B CA1 CA1B CA2 CA2B CA3 CA3B CA4 CA4B RA0 RA0B RA1 RA1B RA2 RA2B RA3 RA3B PREB SAE
+ WL_EN WRITE_EN SDO VDD VSS sram512_controller
xinput_clk CLK VDD VSS sram512_input_clamp
xinput_reset RESET VDD VSS sram512_input_clamp
xinput_sdi SDI VDD VSS sram512_input_clamp
xinput_we WE VDD VSS sram512_input_clamp
* noconn SOUTB
* noconn RA0B
* noconn RA1B
* noconn RA2B
* noconn RA3B
.ends


* expanding   symbol:  sram512_array.sym # of pins=82
** sym_path: /home/ishi-kai/sram/sram512_array.sym
** sch_path: /home/ishi-kai/sram/sram512_array.sch
.subckt sram512_array WL0 WL1 WL2 WL3 WL4 WL5 WL6 WL7 WL8 WL9 WL10 WL11 WL12 WL13 WL14 WL15 BL0 BLB0 BL1 BLB1 BL2 BLB2 BL3 BLB3
+ BL4 BLB4 BL5 BLB5 BL6 BLB6 BL7 BLB7 BL8 BLB8 BL9 BLB9 BL10 BLB10 BL11 BLB11 BL12 BLB12 BL13 BLB13 BL14 BLB14 BL15 BLB15 BL16 BLB16
+ BL17 BLB17 BL18 BLB18 BL19 BLB19 BL20 BLB20 BL21 BLB21 BL22 BLB22 BL23 BLB23 BL24 BLB24 BL25 BLB25 BL26 BLB26 BL27 BLB27 BL28 BLB28
+ BL29 BLB29 BL30 BLB30 BL31 BLB31 VDD VSS
*.PININFO WL0:I WL1:I WL2:I WL3:I WL4:I WL5:I WL6:I WL7:I WL8:I WL9:I WL10:I WL11:I WL12:I WL13:I WL14:I WL15:I BL0:B BLB0:B BL1:B
*+ BLB1:B BL2:B BLB2:B BL3:B BLB3:B BL4:B BLB4:B BL5:B BLB5:B BL6:B BLB6:B BL7:B BLB7:B BL8:B BLB8:B BL9:B BLB9:B BL10:B BLB10:B BL11:B
*+ BLB11:B BL12:B BLB12:B BL13:B BLB13:B BL14:B BLB14:B BL15:B BLB15:B BL16:B BLB16:B BL17:B BLB17:B BL18:B BLB18:B BL19:B BLB19:B BL20:B
*+ BLB20:B BL21:B BLB21:B BL22:B BLB22:B BL23:B BLB23:B BL24:B BLB24:B BL25:B BLB25:B BL26:B BLB26:B BL27:B BLB27:B BL28:B BLB28:B BL29:B
*+ BLB29:B BL30:B BLB30:B BL31:B BLB31:B VDD:B VSS:B
xr0c0 WL0 BL0 BLB0 VDD VSS sram512_bitcell
xr0c1 WL0 BL1 BLB1 VDD VSS sram512_bitcell
xr0c2 WL0 BL2 BLB2 VDD VSS sram512_bitcell
xr0c3 WL0 BL3 BLB3 VDD VSS sram512_bitcell
xr0c4 WL0 BL4 BLB4 VDD VSS sram512_bitcell
xr0c5 WL0 BL5 BLB5 VDD VSS sram512_bitcell
xr0c6 WL0 BL6 BLB6 VDD VSS sram512_bitcell
xr0c7 WL0 BL7 BLB7 VDD VSS sram512_bitcell
xr0c8 WL0 BL8 BLB8 VDD VSS sram512_bitcell
xr0c9 WL0 BL9 BLB9 VDD VSS sram512_bitcell
xr0c10 WL0 BL10 BLB10 VDD VSS sram512_bitcell
xr0c11 WL0 BL11 BLB11 VDD VSS sram512_bitcell
xr0c12 WL0 BL12 BLB12 VDD VSS sram512_bitcell
xr0c13 WL0 BL13 BLB13 VDD VSS sram512_bitcell
xr0c14 WL0 BL14 BLB14 VDD VSS sram512_bitcell
xr0c15 WL0 BL15 BLB15 VDD VSS sram512_bitcell
xr0c16 WL0 BL16 BLB16 VDD VSS sram512_bitcell
xr0c17 WL0 BL17 BLB17 VDD VSS sram512_bitcell
xr0c18 WL0 BL18 BLB18 VDD VSS sram512_bitcell
xr0c19 WL0 BL19 BLB19 VDD VSS sram512_bitcell
xr0c20 WL0 BL20 BLB20 VDD VSS sram512_bitcell
xr0c21 WL0 BL21 BLB21 VDD VSS sram512_bitcell
xr0c22 WL0 BL22 BLB22 VDD VSS sram512_bitcell
xr0c23 WL0 BL23 BLB23 VDD VSS sram512_bitcell
xr0c24 WL0 BL24 BLB24 VDD VSS sram512_bitcell
xr0c25 WL0 BL25 BLB25 VDD VSS sram512_bitcell
xr0c26 WL0 BL26 BLB26 VDD VSS sram512_bitcell
xr0c27 WL0 BL27 BLB27 VDD VSS sram512_bitcell
xr0c28 WL0 BL28 BLB28 VDD VSS sram512_bitcell
xr0c29 WL0 BL29 BLB29 VDD VSS sram512_bitcell
xr0c30 WL0 BL30 BLB30 VDD VSS sram512_bitcell
xr0c31 WL0 BL31 BLB31 VDD VSS sram512_bitcell
xr1c0 WL1 BL0 BLB0 VDD VSS sram512_bitcell
xr1c1 WL1 BL1 BLB1 VDD VSS sram512_bitcell
xr1c2 WL1 BL2 BLB2 VDD VSS sram512_bitcell
xr1c3 WL1 BL3 BLB3 VDD VSS sram512_bitcell
xr1c4 WL1 BL4 BLB4 VDD VSS sram512_bitcell
xr1c5 WL1 BL5 BLB5 VDD VSS sram512_bitcell
xr1c6 WL1 BL6 BLB6 VDD VSS sram512_bitcell
xr1c7 WL1 BL7 BLB7 VDD VSS sram512_bitcell
xr1c8 WL1 BL8 BLB8 VDD VSS sram512_bitcell
xr1c9 WL1 BL9 BLB9 VDD VSS sram512_bitcell
xr1c10 WL1 BL10 BLB10 VDD VSS sram512_bitcell
xr1c11 WL1 BL11 BLB11 VDD VSS sram512_bitcell
xr1c12 WL1 BL12 BLB12 VDD VSS sram512_bitcell
xr1c13 WL1 BL13 BLB13 VDD VSS sram512_bitcell
xr1c14 WL1 BL14 BLB14 VDD VSS sram512_bitcell
xr1c15 WL1 BL15 BLB15 VDD VSS sram512_bitcell
xr1c16 WL1 BL16 BLB16 VDD VSS sram512_bitcell
xr1c17 WL1 BL17 BLB17 VDD VSS sram512_bitcell
xr1c18 WL1 BL18 BLB18 VDD VSS sram512_bitcell
xr1c19 WL1 BL19 BLB19 VDD VSS sram512_bitcell
xr1c20 WL1 BL20 BLB20 VDD VSS sram512_bitcell
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
xr15c26 WL15 BL26 BLB26 VDD VSS sram512_bitcell
xr15c27 WL15 BL27 BLB27 VDD VSS sram512_bitcell
xr15c28 WL15 BL28 BLB28 VDD VSS sram512_bitcell
xr15c29 WL15 BL29 BLB29 VDD VSS sram512_bitcell
xr15c30 WL15 BL30 BLB30 VDD VSS sram512_bitcell
xr15c31 WL15 BL31 BLB31 VDD VSS sram512_bitcell
.ends
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
