PenguinEino/opensusi-tr10-sram512/klayout/sram_compact/macro_16x32.spice

.subckt serial_macro_16x32 CLK RESET SDI WE SDO VDD VSS
Xg1 C3B C2B VDD logic1 C0B C1B VSS AND4_X1
Xg2 VDD logic2 logic1 C4 VSS AND2_X1
Xg3 VDD logic3 logic2 C4B VSS OR2
Xg4 VDD logic4 C0B logic3 VSS AND2_X1
Xff_C0 VDD C0B logic4 C0 RESET VSS CLK DFFR
Xg6 VDD toggle1 C1 C0 VSS XOR2
Xg7 VDD logic7 toggle1 logic3 VSS AND2_X1
Xff_C1 VDD C1B logic7 C1 RESET VSS CLK DFFR
Xg9 VDD logic9 C0 C1 VSS AND2_X1
Xg10 VDD toggle2 C2 logic9 VSS XOR2
Xg11 VDD logic11 toggle2 logic3 VSS AND2_X1
Xff_C2 VDD C2B logic11 C2 RESET VSS CLK DFFR
Xg13 C2 VDD logic13 C0 C1 VSS AND3_X1
Xg14 VDD toggle3 C3 logic13 VSS XOR2
Xg15 VDD logic15 toggle3 logic3 VSS AND2_X1
Xff_C3 VDD C3B logic15 C3 RESET VSS CLK DFFR
Xg17 C3 C2 VDD logic17 C0 C1 VSS AND4_X1
Xg18 VDD toggle4 C4 logic17 VSS XOR2
Xg19 VDD logic19 toggle4 logic3 VSS AND2_X1
Xff_C4 VDD C4B logic19 C4 RESET VSS CLK DFFR
Xg21 C4B C3 VDD logic21 C1B C2B VSS AND4_X1
Xg22 VDD logic22 C3B C4B VSS AND2_X1
Xg23 VDD logic23 logic21 logic22 VSS OR2
Xg24 C3 C2B VDD logic24 C0B C1 VSS AND4_X1
Xg25 VDD logic25 logic24 C4B VSS AND2_X1
Xg26 C3 C2B VDD logic26 C0 C1 VSS AND4_X1
Xg27 VDD logic27 logic26 C4B VSS AND2_X1
Xg28 C3 C2 VDD logic28 C0B C1B VSS AND4_X1
Xg29 VDD logic29 logic28 C4B VSS AND2_X1
Xg30 C3 C2 VDD logic30 C0 C1B VSS AND4_X1
Xg31 VDD logic31 logic30 C4B VSS AND2_X1
Xg32 C3 C2 VDD logic32 C0B C1 VSS AND4_X1
Xg33 VDD logic33 logic32 C4B VSS AND2_X1
Xg34 C3 C2 VDD logic34 C0 C1 VSS AND4_X1
Xg35 VDD logic35 logic34 C4B VSS AND2_X1
Xg36 C3B C2B VDD logic36 C0B C1B VSS AND4_X1
Xg37 VDD logic37 logic36 C4 VSS AND2_X1
Xg38 C3B C2B VDD logic38 C0 C1B VSS AND4_X1
Xg39 VDD logic39 logic38 C4 VSS AND2_X1
Xff_PC_ON VDD PREB logic25 PC_ON RESET VSS CLK DFFR
Xg41 VDD logic41 logic31 logic33 VSS OR2
Xff_WL_EN VDD WL_ENB logic41 WL_EN RESET VSS CLK DFFR
Xg43 logic29 logic31 logic33 logic35 VDD logic43 VSS OR4
Xg44 VDD logic44 logic43 W VSS AND2_X1
Xff_WRITE_EN VDD WRITE_ENB logic44 WRITE_EN RESET VSS CLK DFFR
Xg46 VDD WE WE_B VSS INV_X1
Xg47 VDD logic47 WE_B logic25 VSS AND2_X1
Xg48 logic31 VDD logic48 logic27 logic29 VSS OR3
Xg49 VDD logic49 logic48 WB VSS AND2_X1
Xg50 VDD logic50 logic47 logic49 VSS OR2
Xff_TRACK VDD SAE logic50 TRACK RESET VSS CLK DFFR
Xg52 SR0 SDI logic23 VDD SR0_next VSS MUX2
Xff_SR0 VDD SR0B SR0_next SR0 RESET VSS CLK DFFR
Xg54 SR1 SR0 logic23 VDD SR1_next VSS MUX2
Xff_SR1 VDD SR1B SR1_next SR1 RESET VSS CLK DFFR
Xg56 SR2 SR1 logic23 VDD SR2_next VSS MUX2
Xff_SR2 VDD SR2B SR2_next SR2 RESET VSS CLK DFFR
Xg58 SR3 SR2 logic23 VDD SR3_next VSS MUX2
Xff_SR3 VDD SR3B SR3_next SR3 RESET VSS CLK DFFR
Xg60 SR4 SR3 logic23 VDD SR4_next VSS MUX2
Xff_SR4 VDD SR4B SR4_next SR4 RESET VSS CLK DFFR
Xg62 SR5 SR4 logic23 VDD SR5_next VSS MUX2
Xff_SR5 VDD SR5B SR5_next SR5 RESET VSS CLK DFFR
Xg64 SR6 SR5 logic23 VDD SR6_next VSS MUX2
Xff_SR6 VDD SR6B SR6_next SR6 RESET VSS CLK DFFR
Xg66 SR7 SR6 logic23 VDD SR7_next VSS MUX2
Xff_SR7 VDD SR7B SR7_next SR7 RESET VSS CLK DFFR
Xg68 SR8 SR7 logic23 VDD SR8_next VSS MUX2
Xff_SR8 VDD SR8B SR8_next SR8 RESET VSS CLK DFFR
Xg70 SR9 SR8 logic23 VDD SR9_next VSS MUX2
Xff_SR9 VDD SR9B SR9_next SR9 RESET VSS CLK DFFR
Xg72 DIN SR0 logic25 VDD DIN_next VSS MUX2
Xff_DIN VDD DINB DIN_next DIN RESET VSS CLK DFFR
Xg74 CA0 SR1 logic25 VDD CA0_next VSS MUX2
Xff_CA0 VDD CA0B CA0_next CA0 RESET VSS CLK DFFR
Xg76 CA1 SR2 logic25 VDD CA1_next VSS MUX2
Xff_CA1 VDD CA1B CA1_next CA1 RESET VSS CLK DFFR
Xg78 CA2 SR3 logic25 VDD CA2_next VSS MUX2
Xff_CA2 VDD CA2B CA2_next CA2 RESET VSS CLK DFFR
Xg80 CA3 SR4 logic25 VDD CA3_next VSS MUX2
Xff_CA3 VDD CA3B CA3_next CA3 RESET VSS CLK DFFR
Xg82 CA4 SR5 logic25 VDD CA4_next VSS MUX2
Xff_CA4 VDD CA4B CA4_next CA4 RESET VSS CLK DFFR
Xg84 RA0 SR6 logic25 VDD RA0_next VSS MUX2
Xff_RA0 VDD RA0B RA0_next RA0 RESET VSS CLK DFFR
Xg86 RA1 SR7 logic25 VDD RA1_next VSS MUX2
Xff_RA1 VDD RA1B RA1_next RA1 RESET VSS CLK DFFR
Xg88 RA2 SR8 logic25 VDD RA2_next VSS MUX2
Xff_RA2 VDD RA2B RA2_next RA2 RESET VSS CLK DFFR
Xg90 RA3 SR9 logic25 VDD RA3_next VSS MUX2
Xff_RA3 VDD RA3B RA3_next RA3 RESET VSS CLK DFFR
Xg92 W WE logic25 VDD W_next VSS MUX2
Xff_W VDD WB W_next W RESET VSS CLK DFFR
Xg94 VDD logic94 logic37 WB VSS AND2_X1
Xg95 SDO SOUT logic94 VDD SDO_next VSS MUX2
Xff_SDO VDD SDOB SDO_next SDO RESET VSS CLK DFFR
Xg97 VDD logic97 RA0B RA1B VSS AND2_X1
Xg98 VDD logic98 RA0 RA1B VSS AND2_X1
Xg99 VDD logic99 RA0B RA1 VSS AND2_X1
Xg100 VDD logic100 RA0 RA1 VSS AND2_X1
Xg101 VDD logic101 RA2B RA3B VSS AND2_X1
Xg102 VDD logic102 RA2 RA3B VSS AND2_X1
Xg103 VDD logic103 RA2B RA3 VSS AND2_X1
Xg104 VDD logic104 RA2 RA3 VSS AND2_X1
Xg105 WL_EN VDD WL0 logic97 logic101 VSS AND3_X1
Xg106 WL_EN VDD WL1 logic98 logic101 VSS AND3_X1
Xg107 WL_EN VDD WL2 logic99 logic101 VSS AND3_X1
Xg108 WL_EN VDD WL3 logic100 logic101 VSS AND3_X1
Xg109 WL_EN VDD WL4 logic97 logic102 VSS AND3_X1
Xg110 WL_EN VDD WL5 logic98 logic102 VSS AND3_X1
Xg111 WL_EN VDD WL6 logic99 logic102 VSS AND3_X1
Xg112 WL_EN VDD WL7 logic100 logic102 VSS AND3_X1
Xg113 WL_EN VDD WL8 logic97 logic103 VSS AND3_X1
Xg114 WL_EN VDD WL9 logic98 logic103 VSS AND3_X1
Xg115 WL_EN VDD WL10 logic99 logic103 VSS AND3_X1
Xg116 WL_EN VDD WL11 logic100 logic103 VSS AND3_X1
Xg117 WL_EN VDD WL12 logic97 logic104 VSS AND3_X1
Xg118 WL_EN VDD WL13 logic98 logic104 VSS AND3_X1
Xg119 WL_EN VDD WL14 logic99 logic104 VSS AND3_X1
Xg120 WL_EN VDD WL15 logic100 logic104 VSS AND3_X1
Xg121 VDD logic121 CA0B CA1B VSS AND2_X1
Xg122 VDD logic122 CA0 CA1B VSS AND2_X1
Xg123 VDD logic123 CA0B CA1 VSS AND2_X1
Xg124 VDD logic124 CA0 CA1 VSS AND2_X1
Xg125 CA4B VDD logic125 CA2B CA3B VSS AND3_X1
Xg126 CA4B VDD logic126 CA2 CA3B VSS AND3_X1
Xg127 CA4B VDD logic127 CA2B CA3 VSS AND3_X1
Xg128 CA4B VDD logic128 CA2 CA3 VSS AND3_X1
Xg129 CA4 VDD logic129 CA2B CA3B VSS AND3_X1
Xg130 CA4 VDD logic130 CA2 CA3B VSS AND3_X1
Xg131 CA4 VDD logic131 CA2B CA3 VSS AND3_X1
Xg132 CA4 VDD logic132 CA2 CA3 VSS AND3_X1
Xg133 VDD COL0 logic121 logic125 VSS AND2_X1
Xg134 VDD COL1 logic122 logic125 VSS AND2_X1
Xg135 VDD COL2 logic123 logic125 VSS AND2_X1
Xg136 VDD COL3 logic124 logic125 VSS AND2_X1
Xg137 VDD COL4 logic121 logic126 VSS AND2_X1
Xg138 VDD COL5 logic122 logic126 VSS AND2_X1
Xg139 VDD COL6 logic123 logic126 VSS AND2_X1
Xg140 VDD COL7 logic124 logic126 VSS AND2_X1
Xg141 VDD COL8 logic121 logic127 VSS AND2_X1
Xg142 VDD COL9 logic122 logic127 VSS AND2_X1
Xg143 VDD COL10 logic123 logic127 VSS AND2_X1
Xg144 VDD COL11 logic124 logic127 VSS AND2_X1
Xg145 VDD COL12 logic121 logic128 VSS AND2_X1
Xg146 VDD COL13 logic122 logic128 VSS AND2_X1
Xg147 VDD COL14 logic123 logic128 VSS AND2_X1
Xg148 VDD COL15 logic124 logic128 VSS AND2_X1
Xg149 VDD COL16 logic121 logic129 VSS AND2_X1
Xg150 VDD COL17 logic122 logic129 VSS AND2_X1
Xg151 VDD COL18 logic123 logic129 VSS AND2_X1
Xg152 VDD COL19 logic124 logic129 VSS AND2_X1
Xg153 VDD COL20 logic121 logic130 VSS AND2_X1
Xg154 VDD COL21 logic122 logic130 VSS AND2_X1
Xg155 VDD COL22 logic123 logic130 VSS AND2_X1
Xg156 VDD COL23 logic124 logic130 VSS AND2_X1
Xg157 VDD COL24 logic121 logic131 VSS AND2_X1
Xg158 VDD COL25 logic122 logic131 VSS AND2_X1
Xg159 VDD COL26 logic123 logic131 VSS AND2_X1
Xg160 VDD COL27 logic124 logic131 VSS AND2_X1
Xg161 VDD COL28 logic121 logic132 VSS AND2_X1
Xg162 VDD COL29 logic122 logic132 VSS AND2_X1
Xg163 VDD COL30 logic123 logic132 VSS AND2_X1
Xg164 VDD COL31 logic124 logic132 VSS AND2_X1
Xg165 DIN WRITE_EN PD_Y PD_YB VDD VSS write_control
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
* device instance $108 r0 *1 718.2,5.7 NMOS
XM$108 \$I3612 WL0 BLB29 VSS NMOS L=1u W=3.4u AS=6.12p AD=9.52p PS=7u PD=12.4u
* device instance $109 r0 *1 730.8,26.1 PMOS
XM$109 \$I3615 \$I3614 VDD VDD PMOS L=1u W=3.4u AS=10.88p AD=6.46p PS=13.2u
+ PD=7.2u
* device instance $110 r0 *1 735.6,26.1 PMOS
XM$110 VDD \$I3615 \$I3614 VDD PMOS L=1u W=3.4u AS=6.46p AD=10.88p PS=7.2u
+ PD=13.2u
* device instance $111 r0 *1 726.2,5.7 NMOS
XM$111 BL30 WL0 \$I3615 VSS NMOS L=1u W=3.4u AS=9.52p AD=6.12p PS=12.4u PD=7u
* device instance $112 r0 *1 730.8,5.7 NMOS
XM$112 \$I3615 \$I3614 VSS VSS NMOS L=1u W=3.4u AS=6.12p AD=6.46p PS=7u PD=7.2u
* device instance $113 r0 *1 735.6,5.7 NMOS
XM$113 VSS \$I3615 \$I3614 VSS NMOS L=1u W=3.4u AS=6.46p AD=6.12p PS=7.2u PD=7u
* device instance $114 r0 *1 740.2,5.7 NMOS
XM$114 \$I3614 WL0 BLB30 VSS NMOS L=1u W=3.4u AS=6.12p AD=9.52p PS=7u PD=12.4u
* device instance $115 r0 *1 752.8,26.1 PMOS
XM$115 \$I3617 \$I3616 VDD VDD PMOS L=1u W=3.4u AS=10.88p AD=6.46p PS=13.2u
+ PD=7.2u
* device instance $116 r0 *1 757.6,26.1 PMOS
XM$116 VDD \$I3617 \$I3616 VDD PMOS L=1u W=3.4u AS=6.46p AD=10.88p PS=7.2u
+ PD=13.2u
* device instance $117 r0 *1 748.2,5.7 NMOS
XM$117 BL31 WL0 \$I3617 VSS NMOS L=1u W=3.4u AS=9.52p AD=6.12p PS=12.4u PD=7u
* device instance $118 r0 *1 752.8,5.7 NMOS
XM$118 \$I3617 \$I3616 VSS VSS NMOS L=1u W=3.4u AS=6.12p AD=6.46p PS=7u PD=7.2u
* device instance $119 r0 *1 757.6,5.7 NMOS
XM$119 VSS \$I3617 \$I3616 VSS NMOS L=1u W=3.4u AS=6.46p AD=6.12p PS=7.2u PD=7u
* device instance $120 r0 *1 762.2,5.7 NMOS
XM$120 \$I3616 WL0 BLB31 VSS NMOS L=1u W=3.4u AS=6.12p AD=9.52p PS=7u PD=12.4u
* device instance $121 r0 *1 467.6,26.1 PMOS
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
