PenguinEino/opensusi-tr10-sram512/klayout/sram_macro_study/macro_16x16.spice

.subckt serial_macro_16x16 CLK RESET SDI WE SDO VDD VSS
Xg1 VDD logic1 C0B C4B VSS AND2_X1
Xff_C0 VDD C0B logic1 C0 RESET VSS CLK DFFR
Xg3 VDD toggle1 C1 C0 VSS XOR2
Xg4 VDD logic4 toggle1 C4B VSS AND2_X1
Xff_C1 VDD C1B logic4 C1 RESET VSS CLK DFFR
Xg6 VDD logic6 C0 C1 VSS AND2_X1
Xg7 VDD toggle2 C2 logic6 VSS XOR2
Xg8 VDD logic8 toggle2 C4B VSS AND2_X1
Xff_C2 VDD C2B logic8 C2 RESET VSS CLK DFFR
Xg10 C2 VDD logic10 C0 C1 VSS AND3_X1
Xg11 VDD toggle3 C3 logic10 VSS XOR2
Xg12 VDD logic12 toggle3 C4B VSS AND2_X1
Xff_C3 VDD C3B logic12 C3 RESET VSS CLK DFFR
Xg14 C3 C2 VDD logic14 C0 C1 VSS AND4_X1
Xg15 VDD toggle4 C4 logic14 VSS XOR2
Xg16 VDD logic16 toggle4 C4B VSS AND2_X1
Xff_C4 VDD C4B logic16 C4 RESET VSS CLK DFFR
Xg18 C3 C2B VDD logic18 C0B C1B VSS AND4_X1
Xg19 VDD logic19 logic18 C4B VSS AND2_X1
Xg20 VDD logic20 C3B C4B VSS AND2_X1
Xg21 VDD logic21 logic19 logic20 VSS OR2
Xg22 C3 C2B VDD logic22 C0 C1B VSS AND4_X1
Xg23 VDD logic23 logic22 C4B VSS AND2_X1
Xg24 C3 C2B VDD logic24 C0B C1 VSS AND4_X1
Xg25 VDD logic25 logic24 C4B VSS AND2_X1
Xg26 C3 C2B VDD logic26 C0 C1 VSS AND4_X1
Xg27 VDD logic27 logic26 C4B VSS AND2_X1
Xg28 C3 C2 VDD logic28 C0B C1B VSS AND4_X1
Xg29 VDD logic29 logic28 C4B VSS AND2_X1
Xg30 C3 C2 VDD logic30 C0 C1B VSS AND4_X1
Xg31 VDD logic31 logic30 C4B VSS AND2_X1
Xg32 C3 C2 VDD logic32 C0B C1 VSS AND4_X1
Xg33 VDD logic33 logic32 C4B VSS AND2_X1
Xg34 C3 C2 VDD logic34 C0 C1 VSS AND4_X1
Xg35 VDD logic35 logic34 C4B VSS AND2_X1
Xg36 C3B C2B VDD logic36 C0B C1B VSS AND4_X1
Xg37 VDD logic37 logic36 C4 VSS AND2_X1
Xff_PC_ON VDD PREB logic23 PC_ON RESET VSS CLK DFFR
Xg39 VDD logic39 logic29 logic31 VSS OR2
Xff_WL_EN VDD WL_ENB logic39 WL_EN RESET VSS CLK DFFR
Xg41 logic27 logic29 logic31 logic33 VDD logic41 VSS OR4
Xg42 VDD logic42 logic41 W VSS AND2_X1
Xff_WRITE_EN VDD WRITE_ENB logic42 WRITE_EN RESET VSS CLK DFFR
Xg44 VDD WE WE_B VSS INV_X1
Xg45 VDD logic45 WE_B logic23 VSS AND2_X1
Xg46 logic29 VDD logic46 logic25 logic27 VSS OR3
Xg47 VDD logic47 logic46 WB VSS AND2_X1
Xg48 VDD logic48 logic45 logic47 VSS OR2
Xff_TRACK VDD SAE logic48 TRACK RESET VSS CLK DFFR
Xg50 SR0 SDI logic21 VDD SR0_next VSS MUX2
Xff_SR0 VDD SR0B SR0_next SR0 RESET VSS CLK DFFR
Xg52 SR1 SR0 logic21 VDD SR1_next VSS MUX2
Xff_SR1 VDD SR1B SR1_next SR1 RESET VSS CLK DFFR
Xg54 SR2 SR1 logic21 VDD SR2_next VSS MUX2
Xff_SR2 VDD SR2B SR2_next SR2 RESET VSS CLK DFFR
Xg56 SR3 SR2 logic21 VDD SR3_next VSS MUX2
Xff_SR3 VDD SR3B SR3_next SR3 RESET VSS CLK DFFR
Xg58 SR4 SR3 logic21 VDD SR4_next VSS MUX2
Xff_SR4 VDD SR4B SR4_next SR4 RESET VSS CLK DFFR
Xg60 SR5 SR4 logic21 VDD SR5_next VSS MUX2
Xff_SR5 VDD SR5B SR5_next SR5 RESET VSS CLK DFFR
Xg62 SR6 SR5 logic21 VDD SR6_next VSS MUX2
Xff_SR6 VDD SR6B SR6_next SR6 RESET VSS CLK DFFR
Xg64 SR7 SR6 logic21 VDD SR7_next VSS MUX2
Xff_SR7 VDD SR7B SR7_next SR7 RESET VSS CLK DFFR
Xg66 SR8 SR7 logic21 VDD SR8_next VSS MUX2
Xff_SR8 VDD SR8B SR8_next SR8 RESET VSS CLK DFFR
Xg68 DIN SR0 logic23 VDD DIN_next VSS MUX2
Xff_DIN VDD DINB DIN_next DIN RESET VSS CLK DFFR
Xg70 CA0 SR1 logic23 VDD CA0_next VSS MUX2
Xff_CA0 VDD CA0B CA0_next CA0 RESET VSS CLK DFFR
Xg72 CA1 SR2 logic23 VDD CA1_next VSS MUX2
Xff_CA1 VDD CA1B CA1_next CA1 RESET VSS CLK DFFR
Xg74 CA2 SR3 logic23 VDD CA2_next VSS MUX2
Xff_CA2 VDD CA2B CA2_next CA2 RESET VSS CLK DFFR
Xg76 CA3 SR4 logic23 VDD CA3_next VSS MUX2
Xff_CA3 VDD CA3B CA3_next CA3 RESET VSS CLK DFFR
Xg78 RA0 SR5 logic23 VDD RA0_next VSS MUX2
Xff_RA0 VDD RA0B RA0_next RA0 RESET VSS CLK DFFR
Xg80 RA1 SR6 logic23 VDD RA1_next VSS MUX2
Xff_RA1 VDD RA1B RA1_next RA1 RESET VSS CLK DFFR
Xg82 RA2 SR7 logic23 VDD RA2_next VSS MUX2
Xff_RA2 VDD RA2B RA2_next RA2 RESET VSS CLK DFFR
Xg84 RA3 SR8 logic23 VDD RA3_next VSS MUX2
Xff_RA3 VDD RA3B RA3_next RA3 RESET VSS CLK DFFR
Xg86 W WE logic23 VDD W_next VSS MUX2
Xff_W VDD WB W_next W RESET VSS CLK DFFR
Xg88 VDD logic88 logic35 WB VSS AND2_X1
Xg89 SDO SOUT logic88 VDD SDO_next VSS MUX2
Xff_SDO VDD SDOB SDO_next SDO RESET VSS CLK DFFR
Xg91 VDD logic91 RA0B RA1B VSS AND2_X1
Xg92 VDD logic92 RA0 RA1B VSS AND2_X1
Xg93 VDD logic93 RA0B RA1 VSS AND2_X1
Xg94 VDD logic94 RA0 RA1 VSS AND2_X1
Xg95 VDD logic95 RA2B RA3B VSS AND2_X1
Xg96 VDD logic96 RA2 RA3B VSS AND2_X1
Xg97 VDD logic97 RA2B RA3 VSS AND2_X1
Xg98 VDD logic98 RA2 RA3 VSS AND2_X1
Xg99 WL_EN VDD WL0 logic91 logic95 VSS AND3_X1
Xg100 WL_EN VDD WL1 logic92 logic95 VSS AND3_X1
Xg101 WL_EN VDD WL2 logic93 logic95 VSS AND3_X1
Xg102 WL_EN VDD WL3 logic94 logic95 VSS AND3_X1
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
XM_BL13 BL13 COL13 Y VSS NMOS W=3.4u L=1u
XP_BLB13 BLB13 PREB VDD VDD PMOS W=10.2u L=1u
XM_BLB13 BLB13 COL13 YB VSS NMOS W=3.4u L=1u
XP_BL14 BL14 PREB VDD VDD PMOS W=10.2u L=1u
XM_BL14 BL14 COL14 Y VSS NMOS W=3.4u L=1u
XP_BLB14 BLB14 PREB VDD VDD PMOS W=10.2u L=1u
XM_BLB14 BLB14 COL14 YB VSS NMOS W=3.4u L=1u
XP_BL15 BL15 PREB VDD VDD PMOS W=10.2u L=1u
XM_BL15 BL15 COL15 Y VSS NMOS W=3.4u L=1u
XP_BLB15 BLB15 PREB VDD VDD PMOS W=10.2u L=1u
XM_BLB15 BLB15 COL15 YB VSS NMOS W=3.4u L=1u
XP_Y Y PREB VDD VDD PMOS W=10.2u L=1u
XW_Y Y PD_Y VSS VSS NMOS W=3.4u L=1u
XP_YB YB PREB VDD VDD PMOS W=10.2u L=1u
XW_YB YB PD_YB VSS VSS NMOS W=3.4u L=1u
Xg140 Y YB SAE SOUT SOUTB VDD VSS sense_amp_7t
.ends
* Created by KLayout
*** My special header ***

* cell wlstrap16_16x16
* pin BL0
* pin BL1
* pin BL10
* pin BL11
* pin BL12
* pin BL13
* pin BL14
* pin BL15
* pin BL2
* pin BL3
* pin BL4
* pin BL5
* pin BL6
* pin BL7
* pin BL8
* pin BL9
* pin BLB0
* pin BLB1
* pin BLB10
* pin BLB11
* pin BLB12
* pin BLB13
* pin BLB14
* pin BLB15
* pin BLB2
* pin BLB3
* pin BLB4
* pin BLB5
* pin BLB6
* pin BLB7
* pin BLB8
* pin BLB9
* pin VDD
* pin VSS
* pin WL0
* pin WL1
* pin WL10
* pin WL11
* pin WL12
* pin WL13
* pin WL14
* pin WL15
* pin WL2
* pin WL3
* pin WL4
* pin WL5
* pin WL6
* pin WL7
* pin WL8
* pin WL9
.SUBCKT wlstrap16_16x16 BL0 BL1 BL10 BL11 BL12 BL13 BL14 BL15 BL2 BL3 BL4 BL5
+ BL6 BL7 BL8 BL9 BLB0 BLB1 BLB10 BLB11 BLB12 BLB13 BLB14 BLB15 BLB2 BLB3 BLB4
+ BLB5 BLB6 BLB7 BLB8 BLB9 VDD VSS WL0 WL1 WL10 WL11 WL12 WL13 WL14 WL15 WL2
+ WL3 WL4 WL5 WL6 WL7 WL8 WL9
* device instance $1 r0 *1 239.2,26.1 PMOS
XM$1 \$I1786 \$I1787 VDD VDD PMOS L=1u W=3.4u AS=10.88p AD=6.46p PS=13.2u
+ PD=7.2u
* device instance $2 r0 *1 244,26.1 PMOS
XM$2 VDD \$I1786 \$I1787 VDD PMOS L=1u W=3.4u AS=6.46p AD=10.88p PS=7.2u
+ PD=13.2u
* device instance $3 r0 *1 234.4,5.7 NMOS
XM$3 BL10 WL0 \$I1786 VSS NMOS L=1u W=3.4u AS=10.88p AD=6.46p PS=13.2u PD=7.2u
* device instance $4 r0 *1 239.2,5.7 NMOS
XM$4 \$I1786 \$I1787 VSS VSS NMOS L=1u W=3.4u AS=6.46p AD=6.46p PS=7.2u PD=7.2u
* device instance $5 r0 *1 244,5.7 NMOS
XM$5 VSS \$I1786 \$I1787 VSS NMOS L=1u W=3.4u AS=6.46p AD=6.46p PS=7.2u PD=7.2u
* device instance $6 r0 *1 248.8,5.7 NMOS
XM$6 \$I1787 WL0 BLB10 VSS NMOS L=1u W=3.4u AS=6.46p AD=10.88p PS=7.2u PD=13.2u
* device instance $7 r0 *1 216,26.1 PMOS
XM$7 \$I1788 \$I1789 VDD VDD PMOS L=1u W=3.4u AS=10.88p AD=6.46p PS=13.2u
+ PD=7.2u
* device instance $8 r0 *1 220.8,26.1 PMOS
XM$8 VDD \$I1788 \$I1789 VDD PMOS L=1u W=3.4u AS=6.46p AD=10.88p PS=7.2u
+ PD=13.2u
* device instance $9 r0 *1 211.2,5.7 NMOS
XM$9 BL9 WL0 \$I1788 VSS NMOS L=1u W=3.4u AS=10.88p AD=6.46p PS=13.2u PD=7.2u
* device instance $10 r0 *1 216,5.7 NMOS
XM$10 \$I1788 \$I1789 VSS VSS NMOS L=1u W=3.4u AS=6.46p AD=6.46p PS=7.2u PD=7.2u
* device instance $11 r0 *1 220.8,5.7 NMOS
XM$11 VSS \$I1788 \$I1789 VSS NMOS L=1u W=3.4u AS=6.46p AD=6.46p PS=7.2u PD=7.2u
* device instance $12 r0 *1 225.6,5.7 NMOS
XM$12 \$I1789 WL0 BLB9 VSS NMOS L=1u W=3.4u AS=6.46p AD=10.88p PS=7.2u PD=13.2u
* device instance $13 r0 *1 355.2,26.1 PMOS
XM$13 \$I1790 \$I1791 VDD VDD PMOS L=1u W=3.4u AS=10.88p AD=6.46p PS=13.2u
+ PD=7.2u
* device instance $14 r0 *1 360,26.1 PMOS
XM$14 VDD \$I1790 \$I1791 VDD PMOS L=1u W=3.4u AS=6.46p AD=10.88p PS=7.2u
+ PD=13.2u
* device instance $15 r0 *1 350.4,5.7 NMOS
XM$15 BL15 WL0 \$I1790 VSS NMOS L=1u W=3.4u AS=10.88p AD=6.46p PS=13.2u PD=7.2u
* device instance $16 r0 *1 355.2,5.7 NMOS
XM$16 \$I1790 \$I1791 VSS VSS NMOS L=1u W=3.4u AS=6.46p AD=6.46p PS=7.2u PD=7.2u
* device instance $17 r0 *1 360,5.7 NMOS
XM$17 VSS \$I1790 \$I1791 VSS NMOS L=1u W=3.4u AS=6.46p AD=6.46p PS=7.2u PD=7.2u
* device instance $18 r0 *1 364.8,5.7 NMOS
XM$18 \$I1791 WL0 BLB15 VSS NMOS L=1u W=3.4u AS=6.46p AD=10.88p PS=7.2u PD=13.2u
* device instance $19 r0 *1 169.6,26.1 PMOS
XM$19 \$I1792 \$I1793 VDD VDD PMOS L=1u W=3.4u AS=10.88p AD=6.46p PS=13.2u
+ PD=7.2u
* device instance $20 r0 *1 174.4,26.1 PMOS
XM$20 VDD \$I1792 \$I1793 VDD PMOS L=1u W=3.4u AS=6.46p AD=10.88p PS=7.2u
+ PD=13.2u
* device instance $21 r0 *1 164.8,5.7 NMOS
XM$21 BL7 WL0 \$I1792 VSS NMOS L=1u W=3.4u AS=10.88p AD=6.46p PS=13.2u PD=7.2u
* device instance $22 r0 *1 169.6,5.7 NMOS
XM$22 \$I1792 \$I1793 VSS VSS NMOS L=1u W=3.4u AS=6.46p AD=6.46p PS=7.2u PD=7.2u
* device instance $23 r0 *1 174.4,5.7 NMOS
XM$23 VSS \$I1792 \$I1793 VSS NMOS L=1u W=3.4u AS=6.46p AD=6.46p PS=7.2u PD=7.2u
* device instance $24 r0 *1 179.2,5.7 NMOS
XM$24 \$I1793 WL0 BLB7 VSS NMOS L=1u W=3.4u AS=6.46p AD=10.88p PS=7.2u PD=13.2u
* device instance $25 r0 *1 192.8,26.1 PMOS
XM$25 \$I1794 \$I1795 VDD VDD PMOS L=1u W=3.4u AS=10.88p AD=6.46p PS=13.2u
+ PD=7.2u
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
* device instance $154 r0 *1 7.2,64.9 NMOS
XM$154 \$I1836 \$I1837 VSS VSS NMOS L=1u W=3.4u AS=6.46p AD=6.46p PS=7.2u
+ PD=7.2u
* device instance $155 r0 *1 12,64.9 NMOS
XM$155 VSS \$I1836 \$I1837 VSS NMOS L=1u W=3.4u AS=6.46p AD=6.46p PS=7.2u
+ PD=7.2u
* device instance $156 r0 *1 16.8,64.9 NMOS
XM$156 \$I1837 WL2 BLB0 VSS NMOS L=1u W=3.4u AS=6.46p AD=10.88p PS=7.2u PD=13.2u
* device instance $157 r0 *1 7.2,440.5 PMOS
XM$157 \$I1838 \$I1839 VDD VDD PMOS L=1u W=3.4u AS=10.88p AD=6.46p PS=13.2u
+ PD=7.2u
* device instance $158 r0 *1 12,440.5 PMOS
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
