PenguinEino/opensusi-tr10-sram512/(list of files, drawings)

Other design files:
sram512/reports/schematic_display_equivalence.json
sram512/reports/schematic_previews.json
