PenguinEino/opensusi-tr10-sram512/(commit log)

2026-09-09 Complete 4-bit SRAM layout
    [sram.sch, sram_array.sch]
2026-09-10 Add SRAM sense amplifier and 2x2 column mux verification
    Consolidate SRAM testbenches, add shared pulldown writes and sensed reads, and document nominal verification results. Keep regenerated simulation artifacts out of version control and record ongoing project workflow.
    [sense_amp_7t.sch, sense_amp_input_sweep.csv, sram_array.sch, sram_sim.sch, sram_tb.sch, sram_tb_array.sch, sram_tb_array_mux.sch, sram_tb_cell_sense.sch]
2026-09-11 Add standard-cell row decoder and verify 2x2 SRAM integration
    [row_decoder_1to2.sch, sram_tb_array_row_decoder.sch]
2026-09-11 Add column decoder and verify combined SRAM address selection
    [col_decoder_1to2.sch, sram_tb_array_decoders.sch]
2026-09-11 Remove column enable and verify continuously selected column operation
    [col_decoder_1to2.sch, sram_tb_array_decoders.sch]
2026-09-11 Add standard-cell write control and verify SRAM writes through logic
    [sram_tb_array_write_control.sch, write_control.sch]
2026-09-11 Implement clocked SRAM sequencer and verify complete 2x2 accesses
    [sram_sequencer.sch, sram_tb_sequencer.sch, sync_register_bit.sch]
2026-09-11 Define seven-pin serial SRAM protocol and remove superseded sequencer
    [sram_sequencer.sch, sram_tb_sequencer.sch, sync_register_bit.sch]
2026-09-11 Add readable serial controller schematic and verify 2x2 SRAM against RTL
    [sram_serial_controller.sch, sram_tb_serial.sch]
2026-09-11 Fix serial SRAM schematic ERC warnings and capture ERC in verification
    [sram_serial_controller.sch, sram_tb_serial.sch]
2026-09-11 Validate SRAM macro scaling and estimate capacity with serial peripherals
    [capacity_sweep.csv]
2026-09-11 Implement and verify two-metal T4 SRAM layouts and compare macro capacity
2026-09-11 Share serial receive registers with SRAM access storage
    [sram_serial_controller.sch, sram_tb_serial.sch]
2026-09-11 Recalculate PCell SRAM capacity after register sharing
2026-09-11 Implement 512-bit serial schematics, verify logic and transistor operation
    [sram512.sch, sram512_array.sch, sram512_bitcell.sch, sram512_col_decoder.sch, sram512_column.sch, sram512_control.sch, sram512_controller.sch, sram512_frame.sch]
2026-09-11 Verify full 512-bit SRAM across voltage, temperature and load sensitivity cases
2026-09-11 Verify split 16-column SRAM banks and per-bank wordline drivers
    [sram512.sch, sram512_array.sch, sram512_row_decoder.sch, sram512_tb.sch]
2026-09-11 Route 512-bit study macro and verify strict full-layout DRC and LVS
    [sram512_macro.sch]
2026-09-11 Verify extracted 512-bit SRAM and add input antenna clamps
    [sram512.sch, sram512_input_clamp.sch, sram512_tb.sch]
2026-09-11 Verify extracted SRAM retention and reset; reinforce power paths and record IR margin failure
2026-09-12 Verify MOS voltage limits and width-aware power resistance sensitivity
2026-09-12 Verify unrotated SRAM half-array and row-compatible input clamps
2026-09-12 Unify 32-cell wordlines and verify compact precharge banks
    [sram512.sch, sram512_array.sch, sram512_column.sch, sram512_row_decoder.sch, sram512_tb.sch]
2026-09-12 Record current 16x32 routing blockers and passing decode coverage
2026-09-12 Strengthen SRAM write path and record extracted-circuit stress tests
    [sram512.sch, sram512_column.sch, sram512_tb.sch]
2026-09-12 Validate SRAM startup and PVT; add streamed verification jobs
    [sram512_tb.sch]
2026-09-12 Diagnose decoder voltage excursions and reinforce the physical signal routes
2026-09-12 Save decoder route fixes and readable SRAM512 schematics with verified physical checks
    [schematic_display_equivalence.json, schematic_previews.json, sram512.sch, sram512_array.sch, sram512_col_decoder.sch, sram512_column.sch, sram512_control.sch, sram512_controller.sch]
2026-09-12 Document measured decoder voltage improvement without conflating partial and full tests
2026-09-12 Record passing far-address reset tests and the measured voltage margin
2026-09-12 Verify final SRAM512 submission archive and its editable circuit dependencies
2026-09-13 Preserve existing circuit and verification work before repository organization
    [sram_dense.sch]
2026-09-13 Organize SRAM development, learning assets, and submission tooling
    Preserve existing assets and history while moving schematics, RTL, tools, and learning materials into named folders. Add a portable submission builder and document specifications, integration, appeal, and verification limits. Verify relocated ERC, 512-bit and 2x2 logic, saved-GDS DRC/LVS/masks, and an isolated 16-access MOS testbench.
    [col_decoder_1to2.sch, row_decoder_1to2.sch, sense_amp_7t.sch, sense_amp_input_sweep.csv, sram.sch, sram512.sch, sram512_array.sch, sram512_bitcell.sch]
2026-09-13 Add verified minimal SRAM submission package
    Include editable hierarchical schematics, a portable transistor-level testbench runner, unchanged dev PDK dependencies, drawing and mask GDS, specifications, integration notes, appeal, and current verification reports. Record successful isolated 16-access simulation and ZIP checksum validation.
    [AND2_X1.sch, AND3_X1.sch, AND4_X1.sch, BUF_X4.sch, DFFR.sch, INV_X1.sch, MUX2.sch, OR2.sch]
2026-09-13 Publish flat submission files and retain validation outside the package
    [AND2_X1.sch, AND3_X1.sch, AND4_X1.sch, BUF_X4.sch, DFFR.sch, INV_X1.sch, MUX2.sch, OR2.sch]
2026-09-13 Align submitted SRAM top names and verify default GUI LVS
    [sram512_macro.sch]
2026-09-13 Review SRAM512 circuit topology and transistor-level margins
2026-09-13 Document SRAM512 schematic hierarchy and instance counts
2026-09-13 Update submission with schematic hierarchy
2026-09-13 Include initial hand layout and unify schematic hierarchy diagram
